dakshinatharindu/Hot-Plate/Enclosure/Hot-Plate-using-PID-main/README.md

# Hot-Plate-using-PID
Hot plate using PID. All circuits tested on Multisim
