dakshinatharindu/Hot-Plate/Report/front.tex

\newcommand{\HRule}{\rule{\linewidth}{0.5mm}} 

\begin{titlepage}
\center
%	HEADING & LOGO
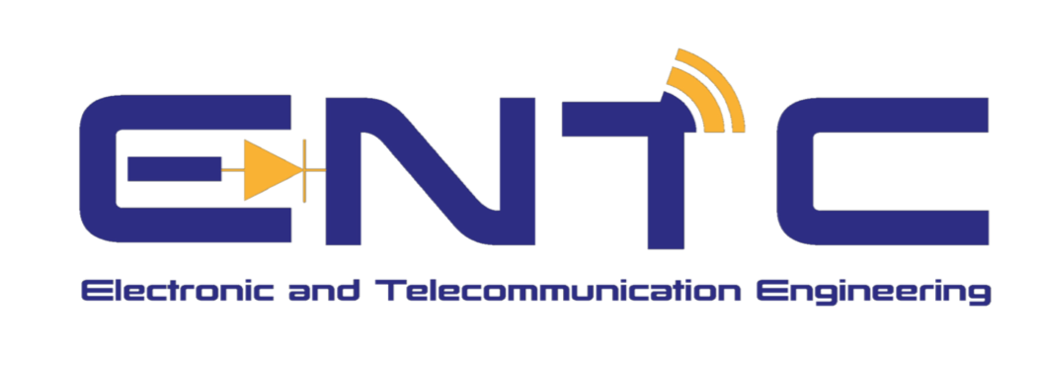
[picture p15: Report/ENTC.png]
\\[1cm]
\textsc{
\Huge \textbf{Department of Electronic \& Telecommunication Engineering}\\[.5cm]
\Large
University of Moratuwa\\[0.5cm] 
Laboratory Practice II - EN2090}\\[0.5cm]

%	TITLE 
\sffamily
\HRule \\[0.4cm]
\textbf{\Huge\textcolor{red}{PID Hotplate Controller}}\\[0.2cm] 
\HRule \\[1cm]
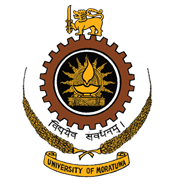
[picture p16: Report/Picture1.png]
\\[1cm]
 \Large
Group 25\\[5mm]
%	AUTHORS & SUPERVISOR
\large
\begin{minipage}[t]{.5\textwidth}
\begin{flushleft}
\emph{ \Large Team Members}

\large 190622R \quad O.K.D. Tharindu\\
\large 190626H \quad P.D. Tharundi \\
\large 190631T \quad T.A. Thenuwara\\
\large 190636M \quad A.G.N. Udara\\
\end{flushleft}

\end{minipage}\hfill\begin{minipage}[t]{.4\textwidth}

\begin{flushright}
\emph{ \Large Course Instructor} 

Mr. Gershorm\\ 

\end{flushright}
\end{minipage}
\end{titlepage}

\begin{abstract}
    This report is a fulfilment for the final evaluation of Laboratory Practice II (EN2090) final group project. We are designing a PID Hotplate controller with analog electronics. As most of Hot plates in the market does not have a temperature controlling mechanism, we are designing a PID feedback controlled temperature managing mechanism. It will help the user to reduce electricity consumption as well as a the life time of the hotplate. We can control the temperature upto $210 ^\circ C$ range. And the controller is designed to work in 2.5KW.
\end{abstract}
