dakshinatharindu/Hot-Plate/Enclosure/Hot-Plate-using-PID-main/Hot Plate/Hot Plate Controller presentation.pptx

## Hot Plate Controller Using PID

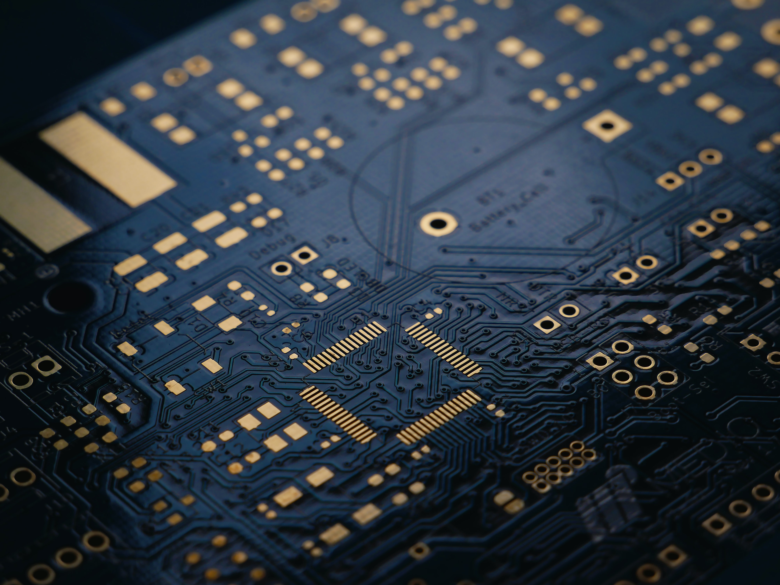
[picture p17: figure]

Group number 19
- 180379R : K.A.G.D. Maheekumara
- 180544U : W.A.V. Ravihansa
- 180604F : P.H.D.S. Silva
- 180715V : U.I.D. Wijethunga

EN2090 – Laboratory Practice II

## Introduction

Power Supply Unit
Sensor interface unit
PID controller Unit
Firing angle controlling system

## Power Supply Unit

## Power supply unit

- This unit is mainly use for give all voltages and current according to the main units.
  - Sensor interfacing unit
  - PID unit
  - Firing angle controller unit
- This unit mainly have 3 parts,
  - Step down part
  - Rectifier part
  - 12V, -12V, 5V output part
- Step down part we mainly use center tapped transformer to convert 230V AC to 12V DC current. Because we cannot use direct house voltage for these circuits.

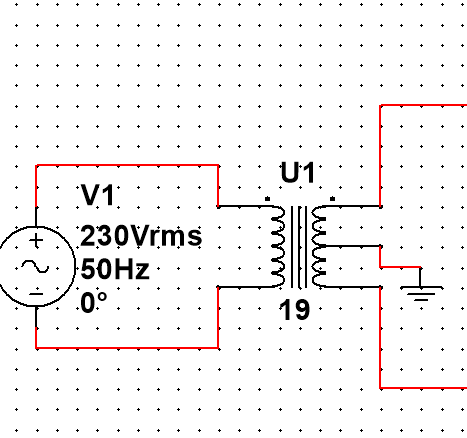
[picture p18: figure]

## Slide 5

- Further we can't use AC current for this circuit so we should convert it to DC current. We can use the second part(Rectifier part) to achieve this purpose. It convert AC voltage to DC voltage.
- Then we can get three output by using,
  - LM7812CT – for 12V DC output
  - LM7912CT – for –12V DC output
  - LM7805CT – for 5V DC output

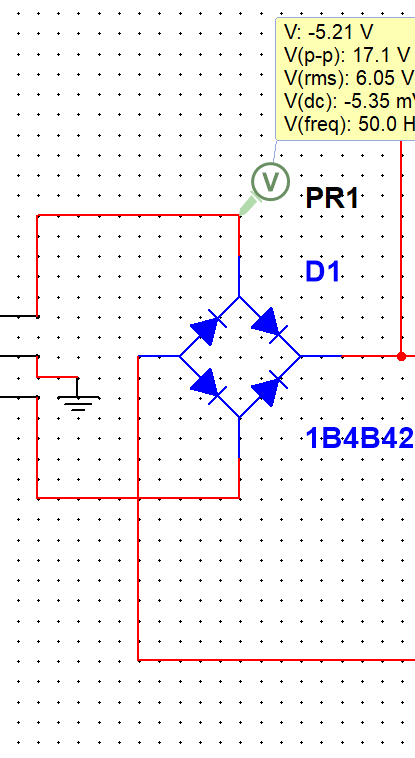
[picture p19: figure]

## Slide 6

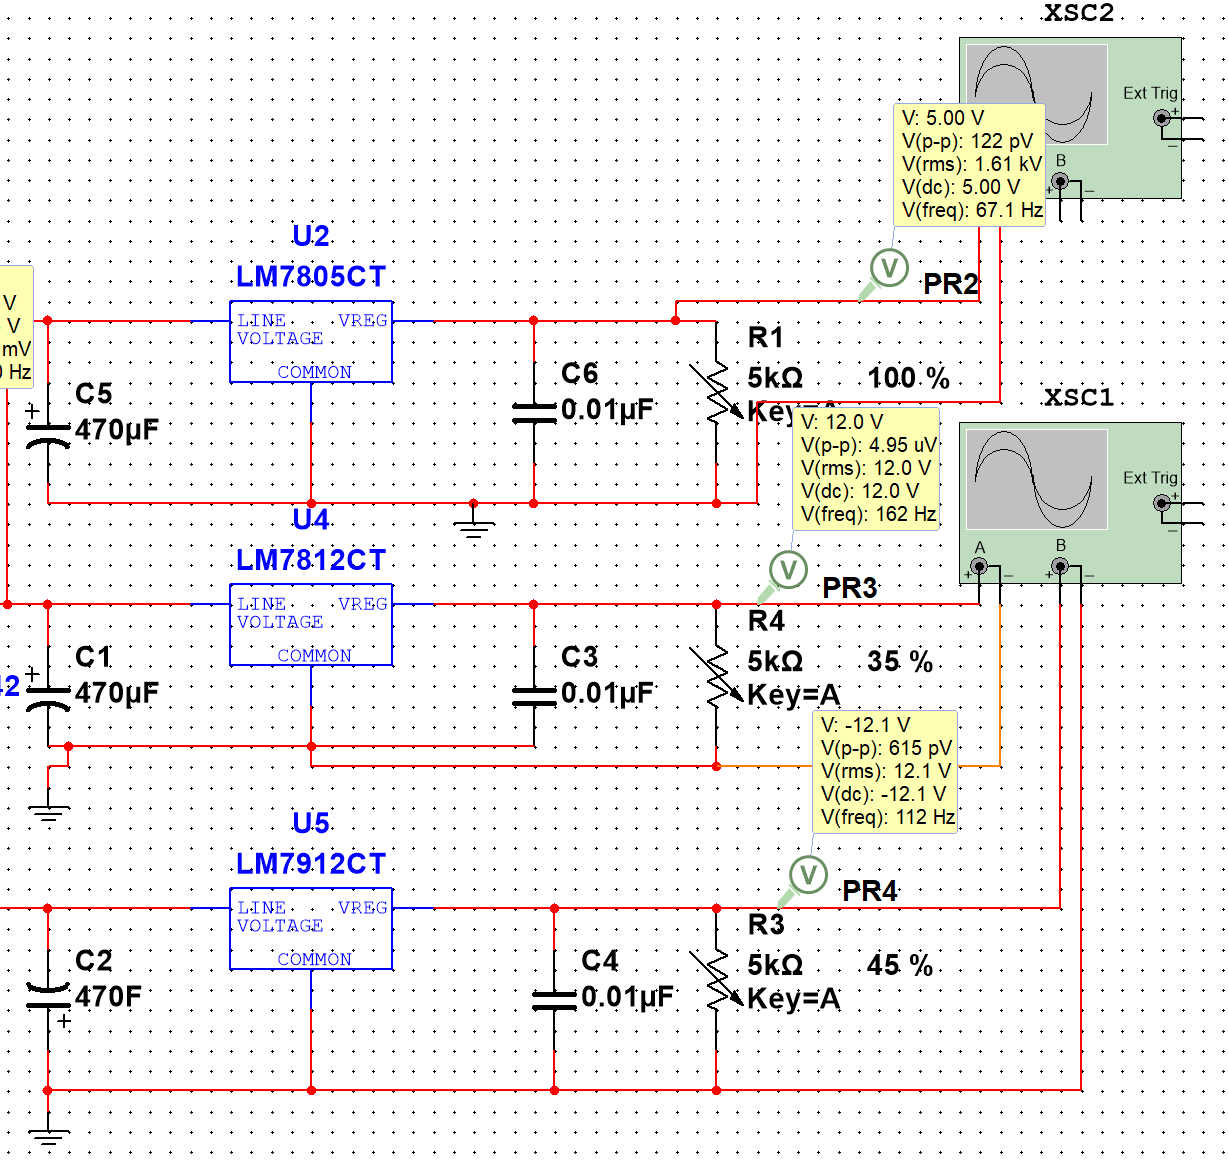
[picture p20: figure]

- Power supply full circuit

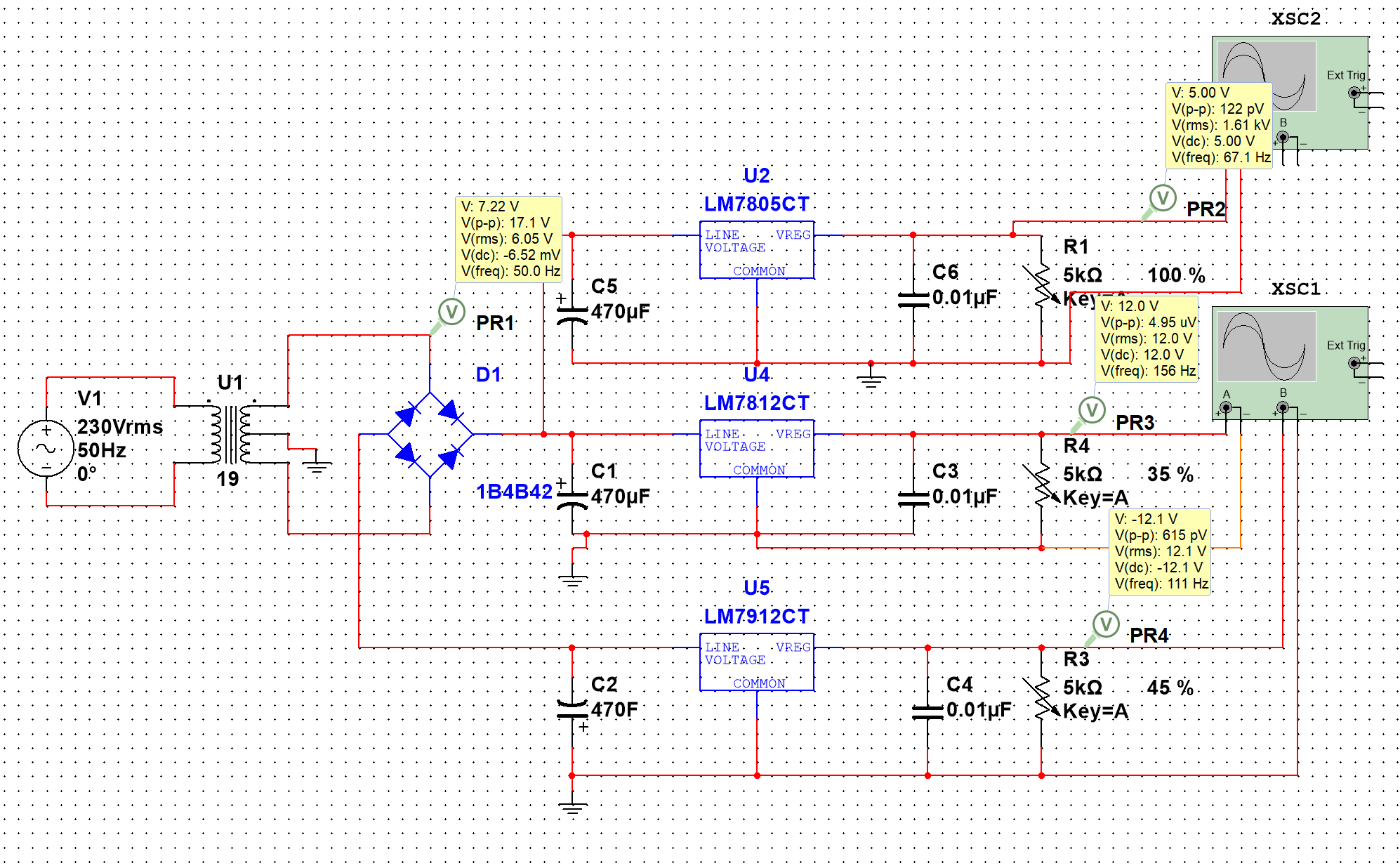
[picture p21: figure]

## Slide 7

Full circuit simulation result
- LM7805CT

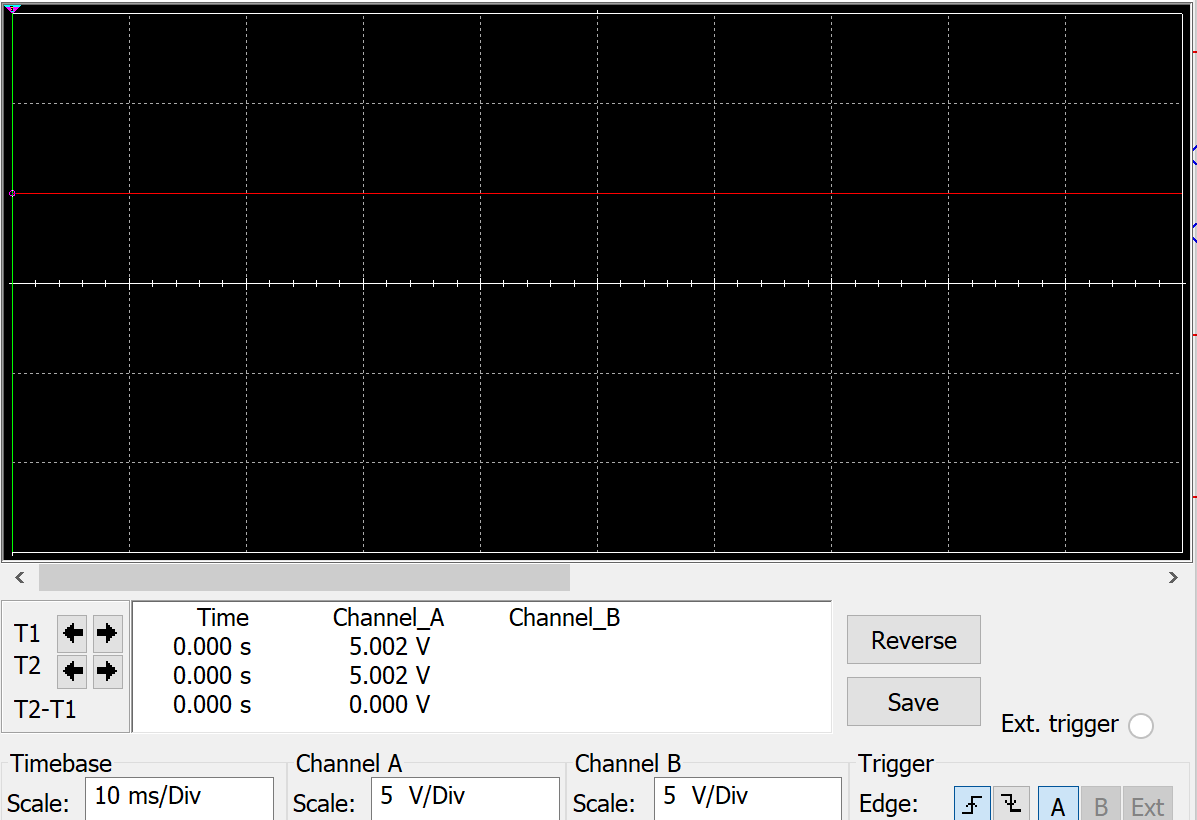
[picture p22: figure]

## Slide 8

LM7812CT and LM7912CT

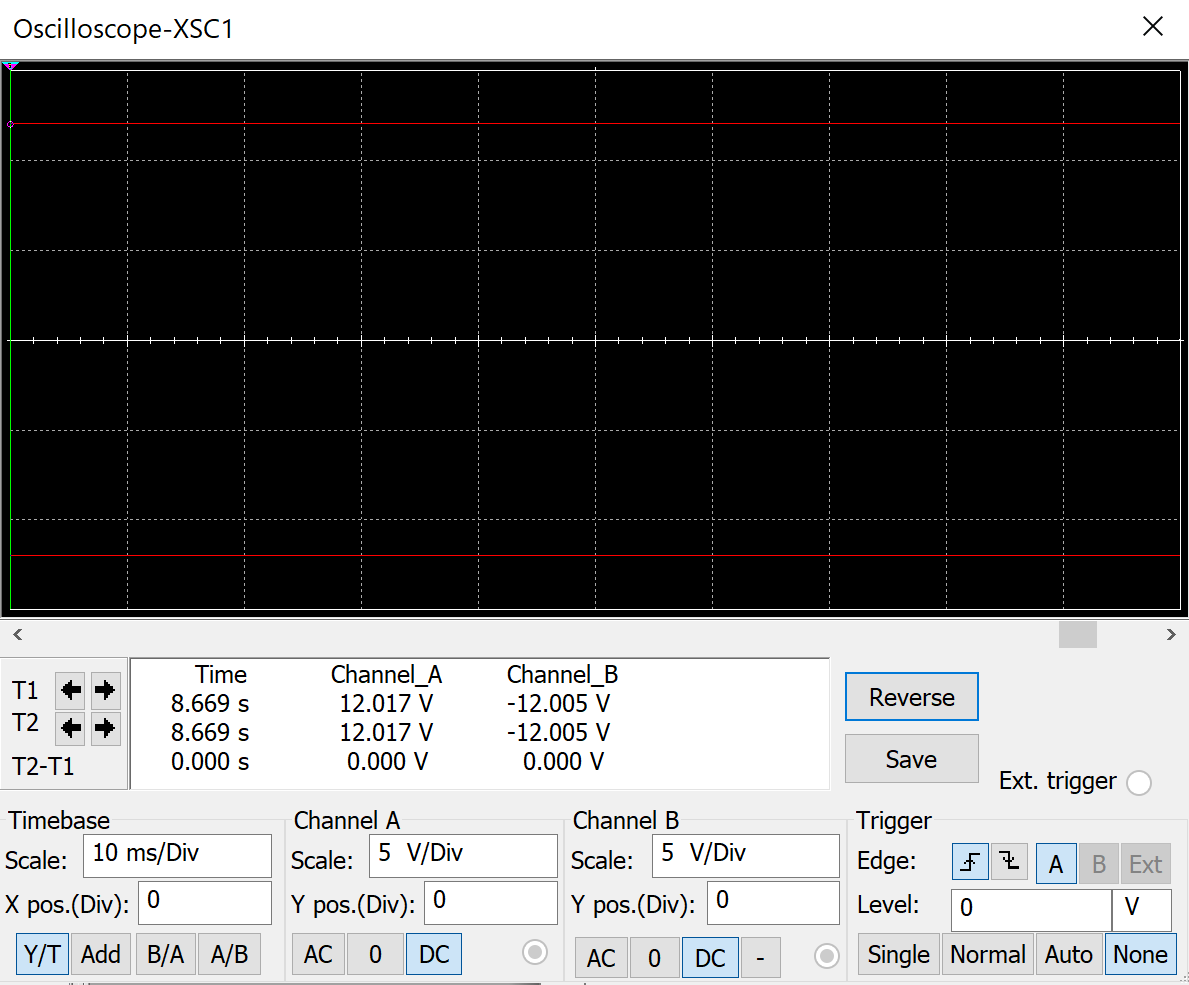
[picture p23: figure]

## Slide 9

- Schematic of Power supply circuit

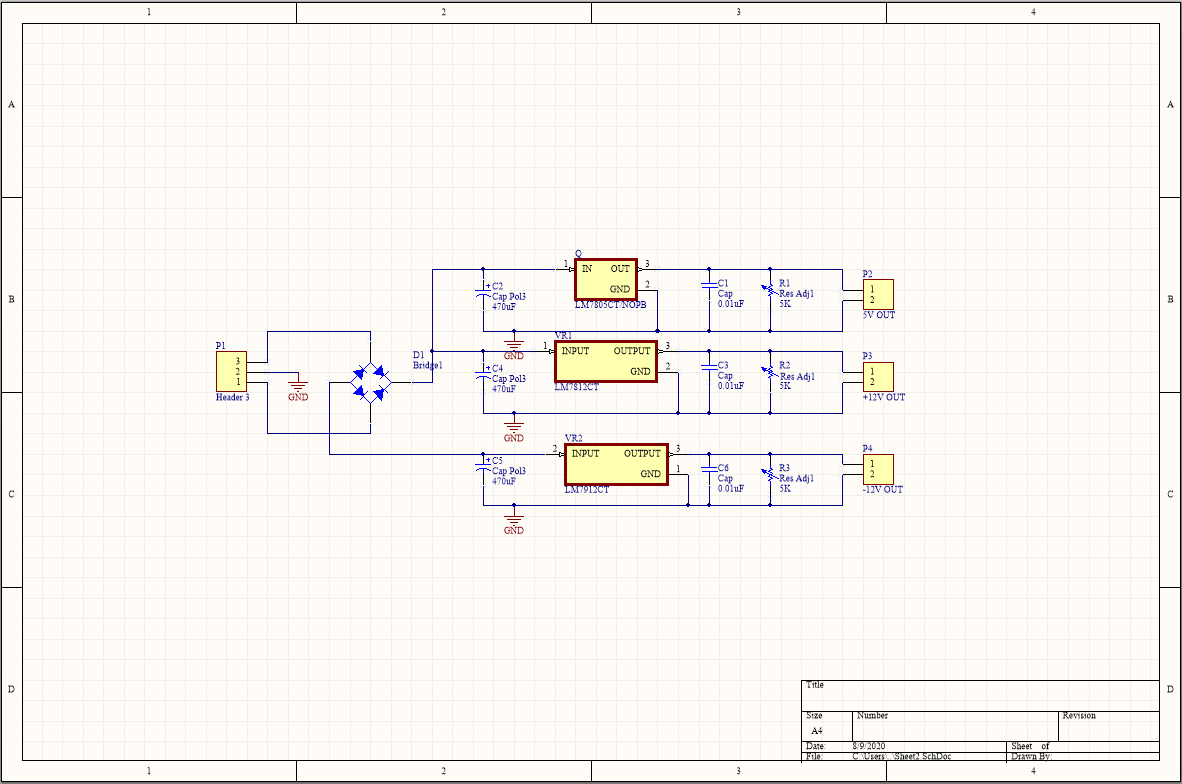
[picture p24: figure]

## Slide 10

- PCB layout of the power supply circuit

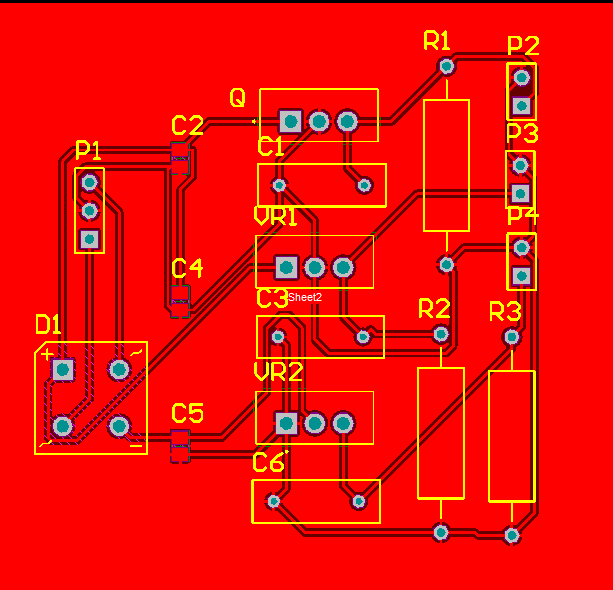
[picture p25: figure]

## SENSOR INTERFACE UNIT

## The resistance variation of the selected sensor RTD Pt100 with temperature is approximately linear,

RTD (T ) ≈ RTD0 ( 1 + T × α )
Where:
RTD(T) = the RTD element’s resistance at T (Ω)
RTD0 = the RTD element’s resistance at 0°C (Ω) (100 Ω for Pt100)
T = the RTD element’s temperature (°C)
α = 0.00385 Ω/Ω/°C (Temperature coefficient of RTD element)
As per actual readings obtained for temperature range 0-200°C the resistance varies in the range 100 –175.86 Ω.
(https://www.tnpinstruments.com/sitebuildercontent/sitebuilderfiles/pt100_385c_table.pdf)

## Slide 13

Analog circuit to take the required temperature, read the sensor reading and to output the difference in temperature as a voltage level.

Comprises with,
- 1mA constant current source.
The RTD requires a 1mA or less constant current for proper operation.
- Error generation and amplification unit.
Generation of error (difference between sensor reading and desired temperature as a voltage - input for PID unit).

## Constant current source

- U3B and R3, R4, R7, R8 resistors serve as a differential amplifier with gain=1,
- VOUT_U3B= 1*( VJ2 – (- VOUT_U3C ))
- VJ2 = VCC/2 =6V
- Since U3C is a unity gain amplifier VOUT_U3C = VJ1 .
- VR2 = VOUT_U3B - VJ1
- = VOUT_U3B - VOUT_U3C
- = VJ2 = 6V
- Therefore current supplied to the sensor= VR2 / R2
- = 1mA.
- ( No backflow at J1 since op amp input resistance is high)

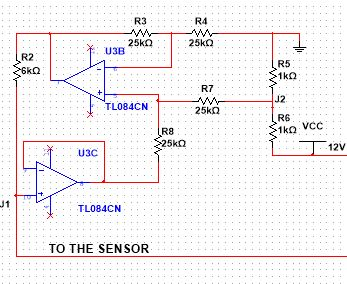
[picture p26: figure]

## Error Generation

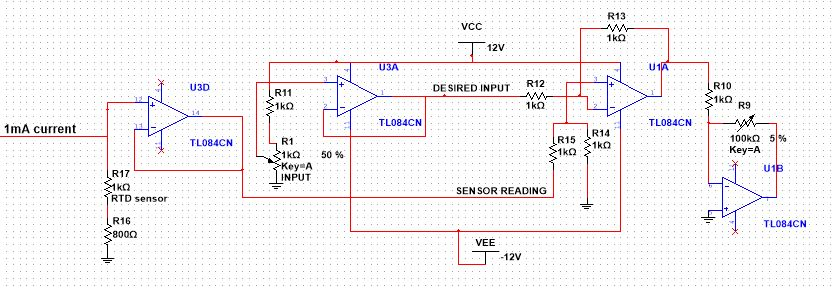
[picture p27: figure]

- U3D is a unity gain op amp ( to isolate circuit currents),
- VOUT_U3D = sensor reading = (RTD resistance + R16) * 1mA
- For simulation purposes a potentiometer is used to input the desired input. U3A is a unity gain op amp ,
- VOUT_U3A = desired input
- U1A is a differential amplifier with gain=1 since all resistance values from R12 to R15 are equal.
- VOUT_U1A = 1 x (sensor reading - desired input)
- = Error input for PID unit
- U1B is an inverting amplifier with variable gain( set by R9 potentiometer and R10 ),
- variable gain = R9/R10

## Slide 16

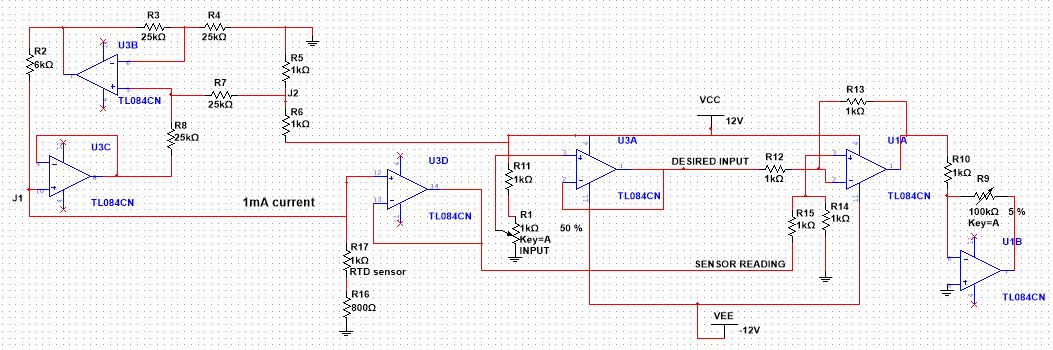
[picture p28: figure]

## ERROR and VOLTAGE ACROSS RTD VS. RTD RESISTANCE (AT 0.9V DESIRED INPUT)

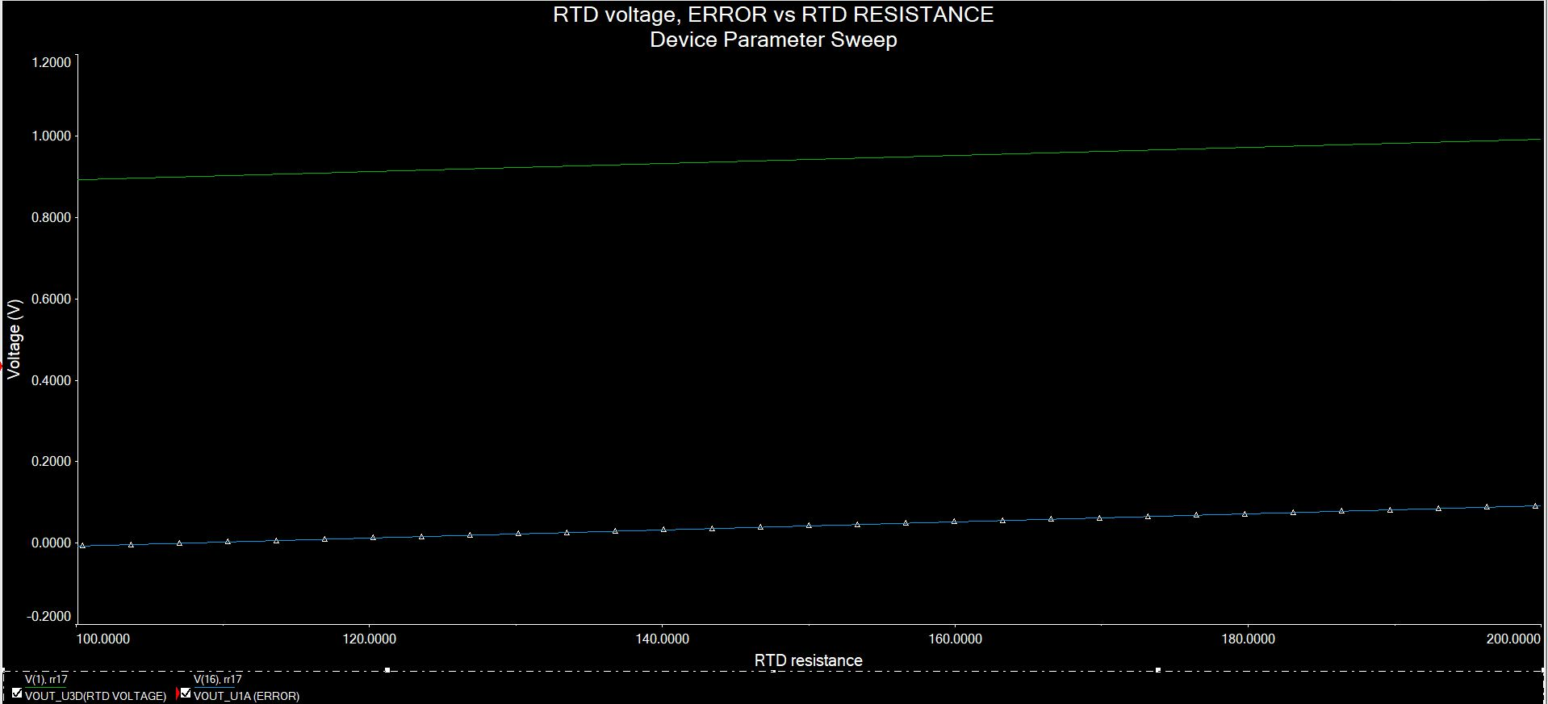
[picture p29: figure]

## CONSTANT CURRENT SUPPLY vs RTD RESISTANCE

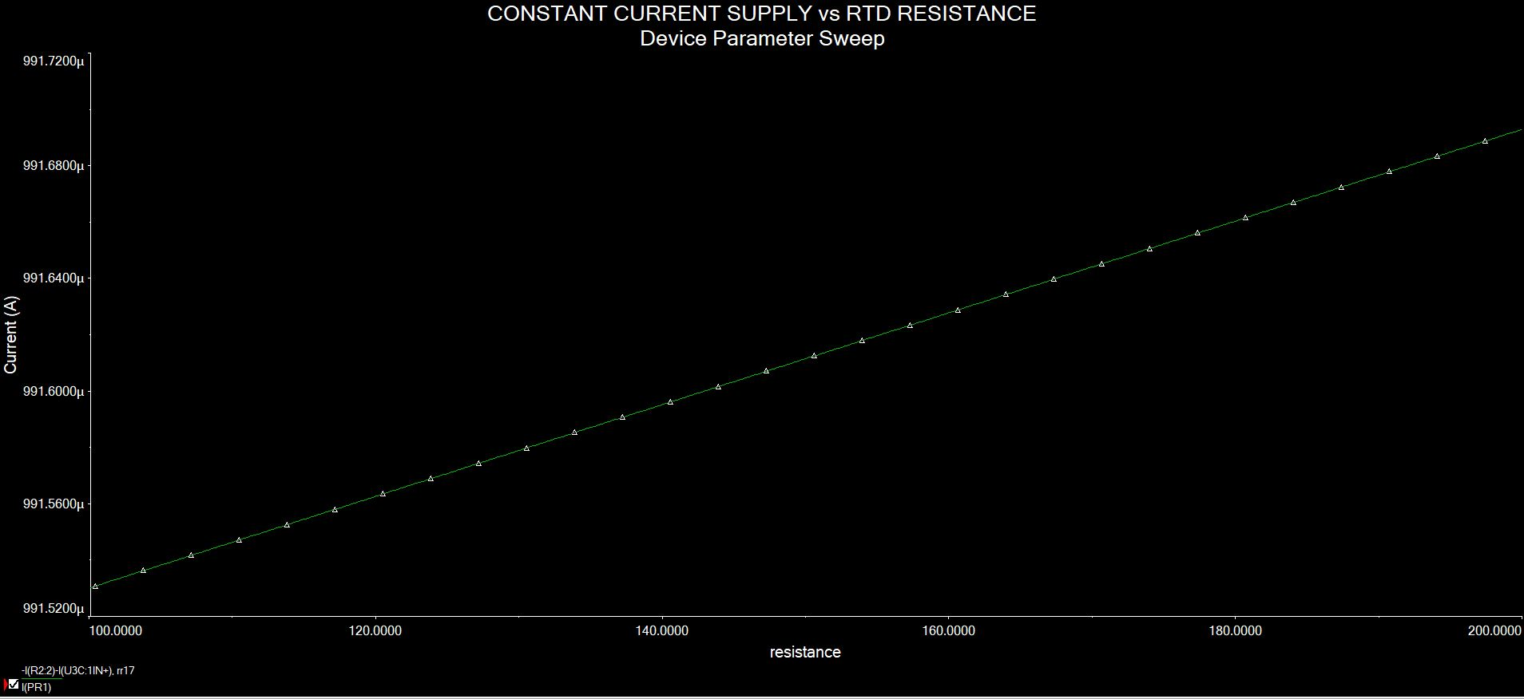
[picture p30: figure]

## PCB Layout

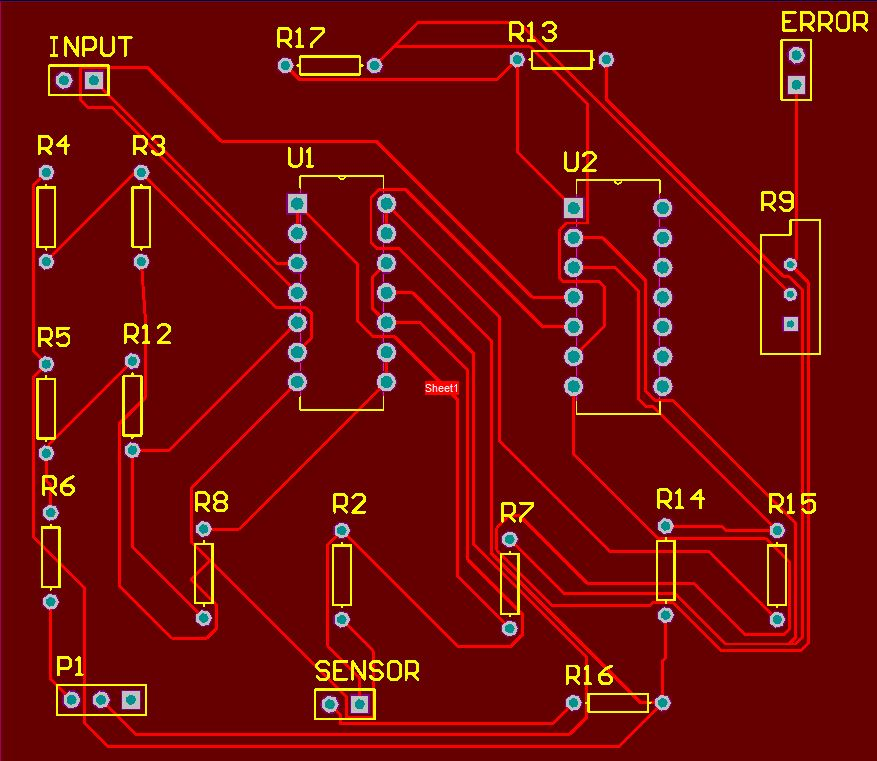
[picture p31: figure]

## PID Controller Unit

## PID CONTROLLER UNIT

The purpose of this unit is take the error between desire value and sensor output value which is generated by the sensor unit. Then this error signal goes through the PID control unit and generate the output controlling signal which is input to the PWM unit.
This unit has three main parts.
- Proportional
- Integral
- Derivative
Block diagram
output(t)=K_p V_(error) + K_i ∫ V_(error) + K_d (d(V_(error) ))/(dt)

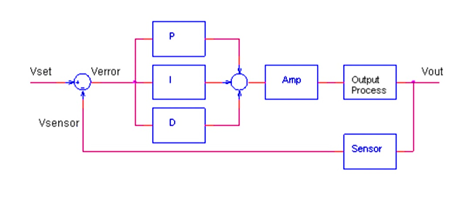
[picture p32: figure]

## Proportional circuit

We use proportional circuit to produce a one control signal which is proportional to the input error signal. This reduce large part of overall error.
Circuit and simulation result
Pout= K_p ∗V_(error)
K_p = R_(P2) /R_(P1) (proportional gain constant)
- We have to change the Kp value to control the gain of the output.

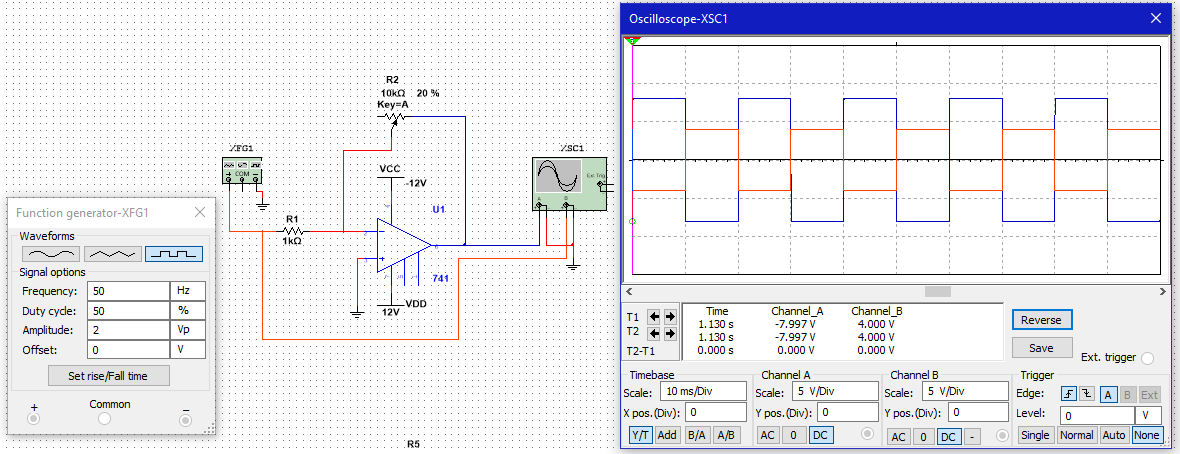
[picture p33: figure]

## Integral circuit

We use integral circuit to produce sum of the instantaneous error over time.
Circuit and simulation result
Iout= K_I ∗ ∫ V_(error) dt
K_I =1/(R_I C_I ) (integral coefficient)
- In the figure we use resistor parallel to the feedback capacitor. The purpose of that resistor is reduce the gain in output.

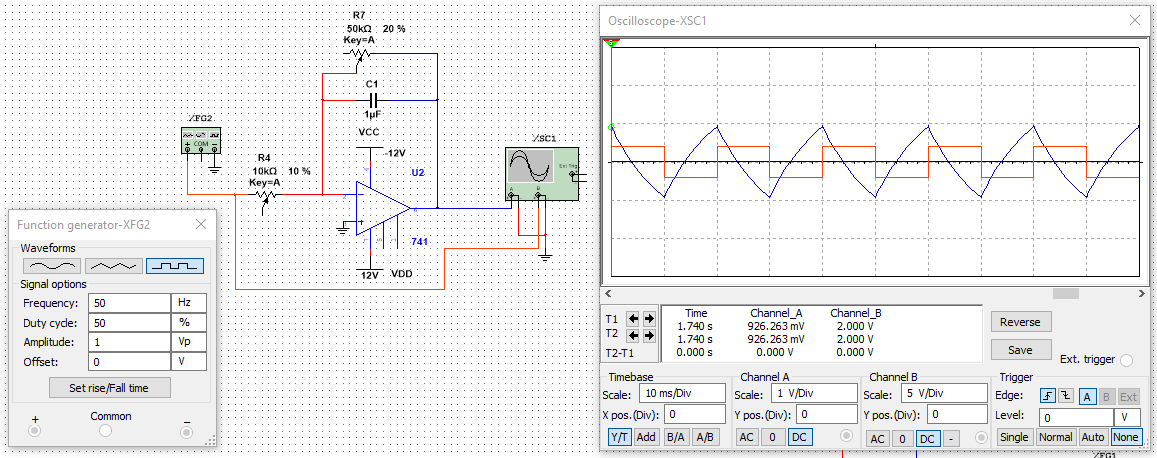
[picture p34: figure]

## Derivative circuit

This circuit counteracts the proportional gain and the integral gain when the output changes quickly.
Circuit and simulation result
D_(out) = K_d ∗ (dV_(error))/(dt)
K_d = R_d ∗C_d (derivative coefficient)
- In the above figure we used resistor series with input capacitor. The reason is circuit may amplify unwanted noises. We can reduce the output gain by using capacitor parallel to the feedback resistor.

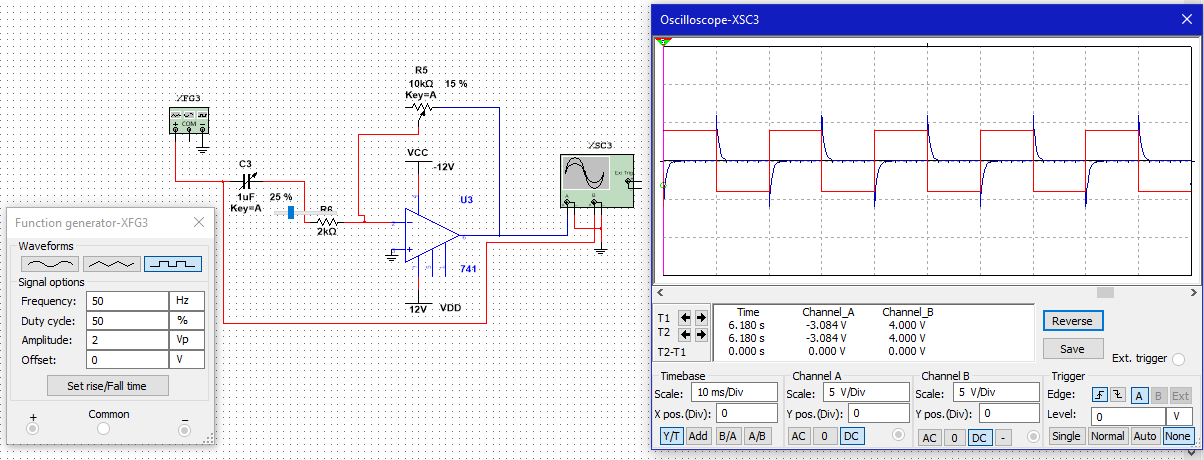
[picture p35: figure]

## Slide 25

- Derivative circuit also helps to reduce the overshoot.

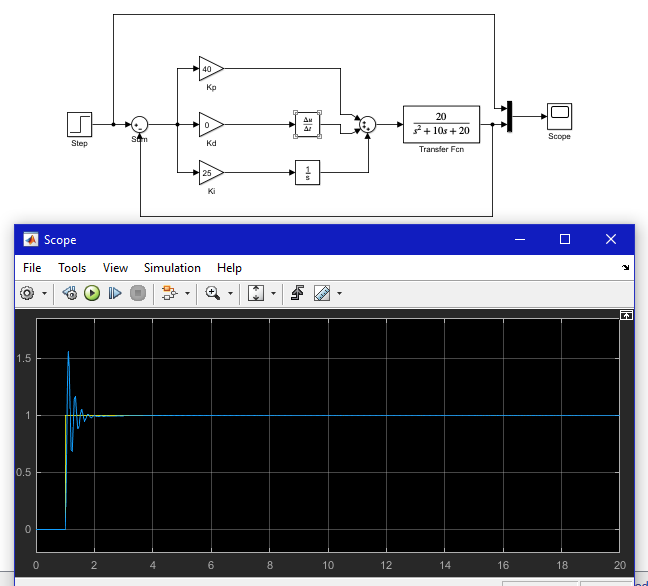
[picture p36: figure]

With out Kd

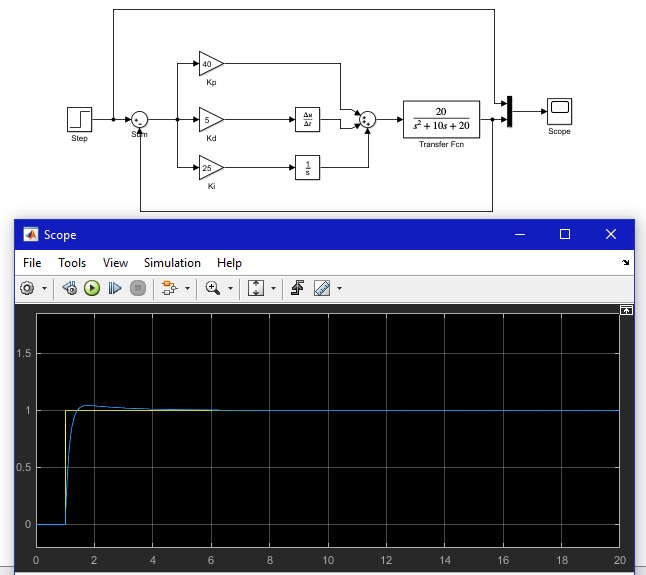
[picture p37: figure]

With Kd

## FINAL CIRCUIT SIMULATION RESULT

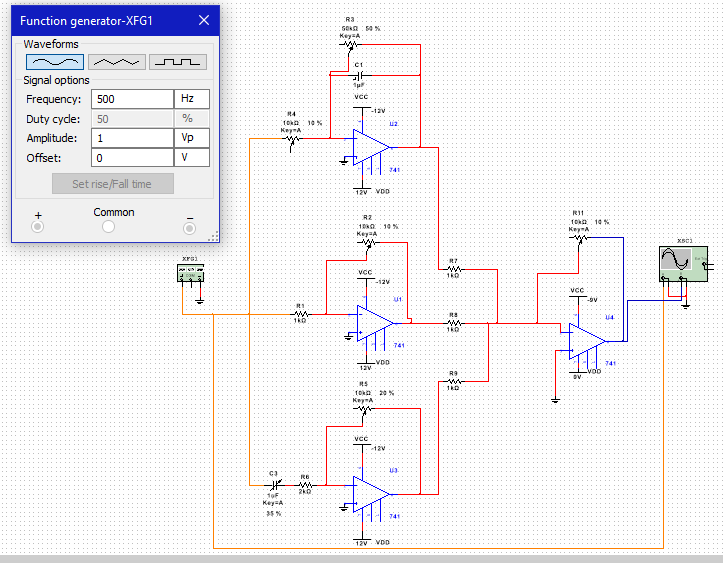
[picture p38: figure]
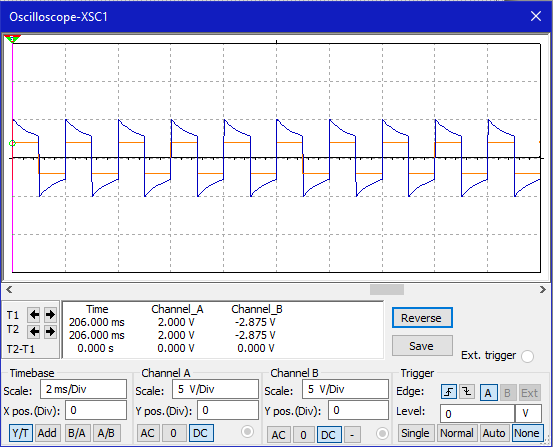
[picture p39: figure]

## PID TUNING

Tuning means adjusting three multipliers Kp, Ki, Kd. We have to adjust these values until we get the desire output from the system.
Tuning method
- Set Kp. Starting with Kp = 0, Ki = 0 and Kd = 0, increase Kp until the output starts overshooting and ringing significantly.
- Set Kd. Increase Kd until the overshoot is reduced to an acceptable level.
- Set Ki. Increase Ki until the final error is equal to zero.

## Slide 28

Schematic and PCB layout

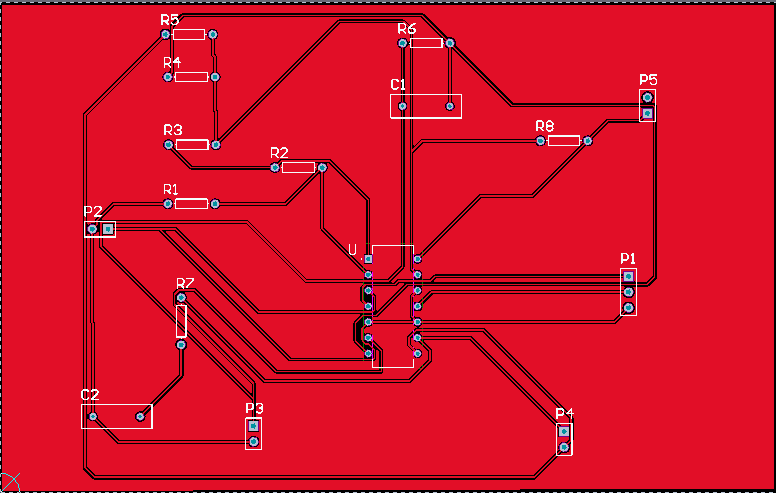
[picture p40: figure]
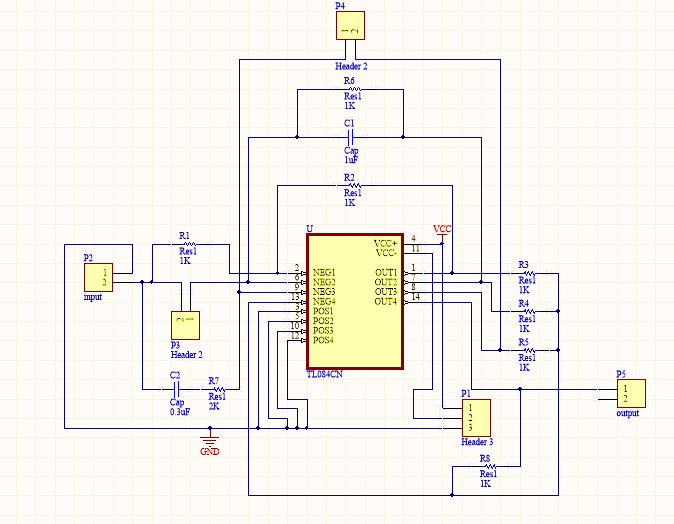
[picture p41: figure]

## Firing Angle Controlling System

## Firing Angle Controlling System

- Controls the transferring power to hotplate according to the PID output.
- Four main parts.
  1. Zero crossing detection
  2. Ramp generation
  3. PWM signal generation
  4. Triggering circuit

## Zero crossing detection

- Provides a pulse train in a frequency that is twice as the 230V AC supply.

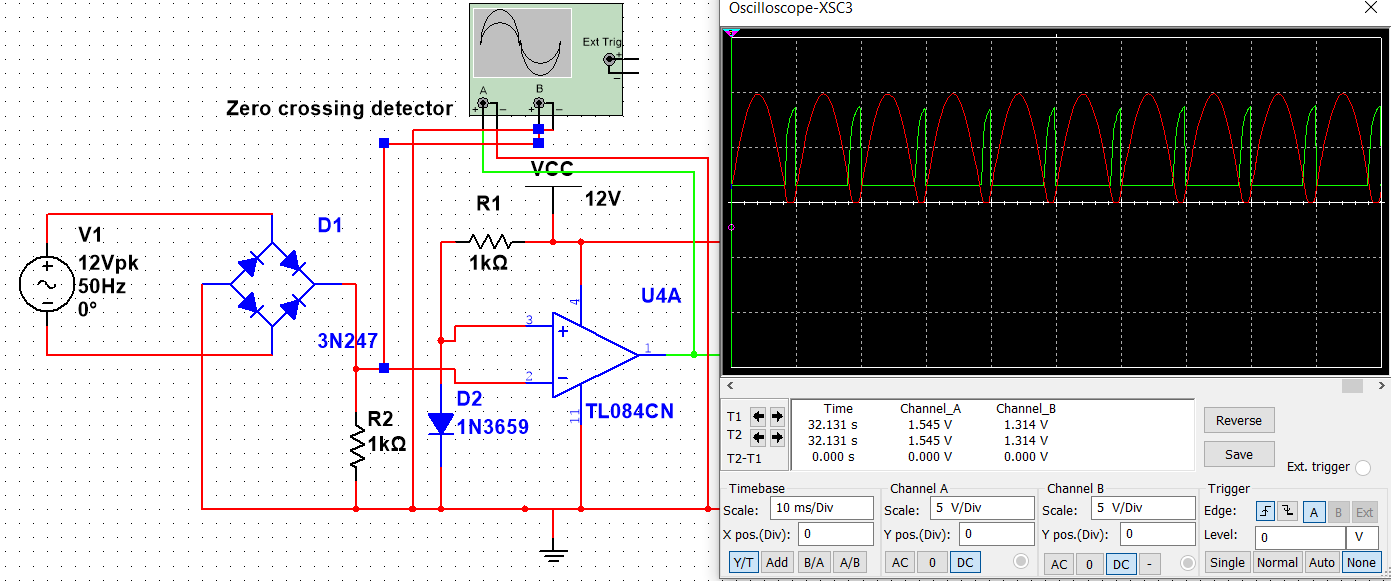
[picture p42: figure]

V_(+) =V_b (Barrier voltage of the D2)
V_(−) = rectifier output voltage
Op amp act as a comparator,
Therefore ,
If V_(+) > V_(−) ,
V_o =+V_s
If V_(+) < V_(−) ,
V_o =−V_s
Maximum current through the diode(In datasheet) = 30A
R1=1kΩ
Current through the diode in this circuit ≈ 11.4mA

## Ramp generation

- Creates a ramp using each pulse.

- The pulse train is given to the base of the transistor.
- When base voltage is low, the transistor act as a open switch.
V_C =V_(CC)
Capacitor is charge up to the collector voltage.
- When base voltage is high, the transistor is act as a closed switch. Collector-Emitter voltage will be nearly zero. Capacitor will discharge through the transistor.

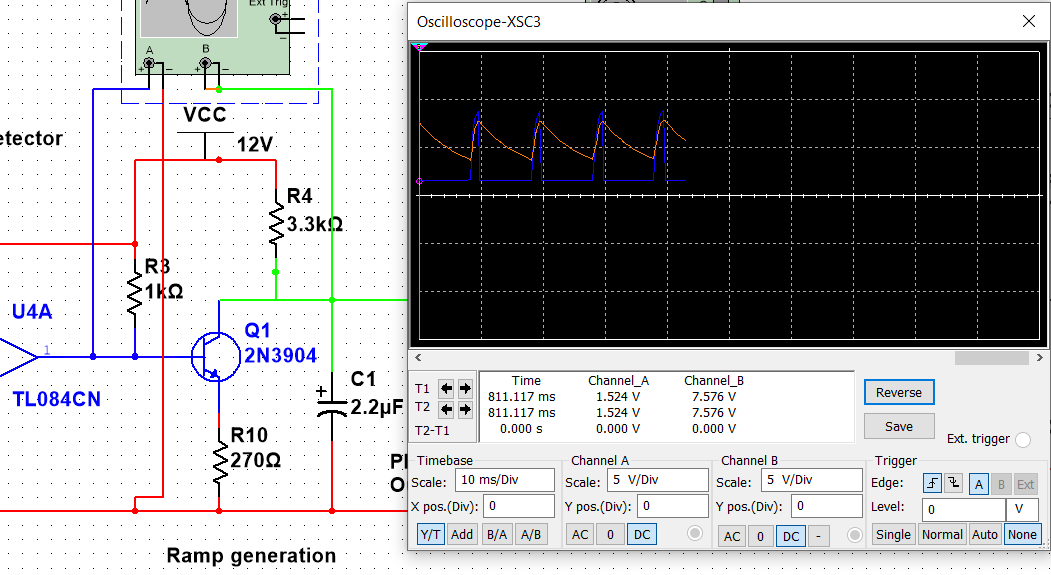
[picture p43: figure]

## PWM signal generation

- Provides a PWM signal which changes its pulse width according to the PID output signal.

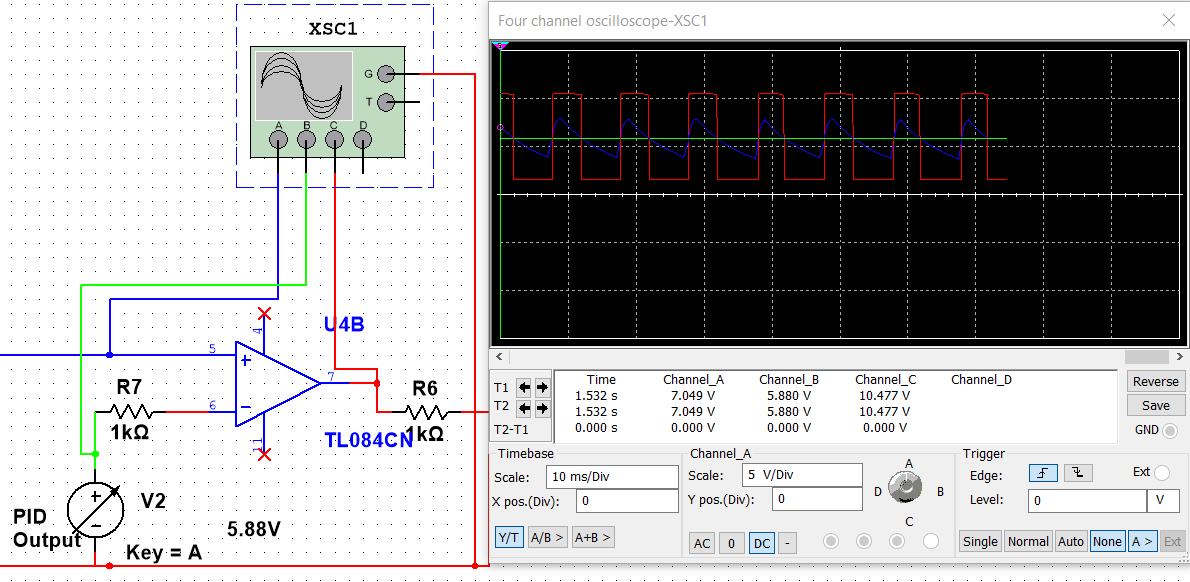
[picture p44: figure]

Op amp act as a comparator,
V_(+) =generated ramp wave
V_(−) =PID output signal
If V_(+) >V_(−) ,
V_o =+ V_s (12V)
If V_(+) <V_(−) ,
V_o =− V_s (0V)

## Triggering Circuit

- This circuit is isolated using an opto-transistor to protect the low power, control circuit from the 230V circuit.
- Once the triac is triggered using a high voltage it allows to flow current trough out the circuit until current becomes zero.

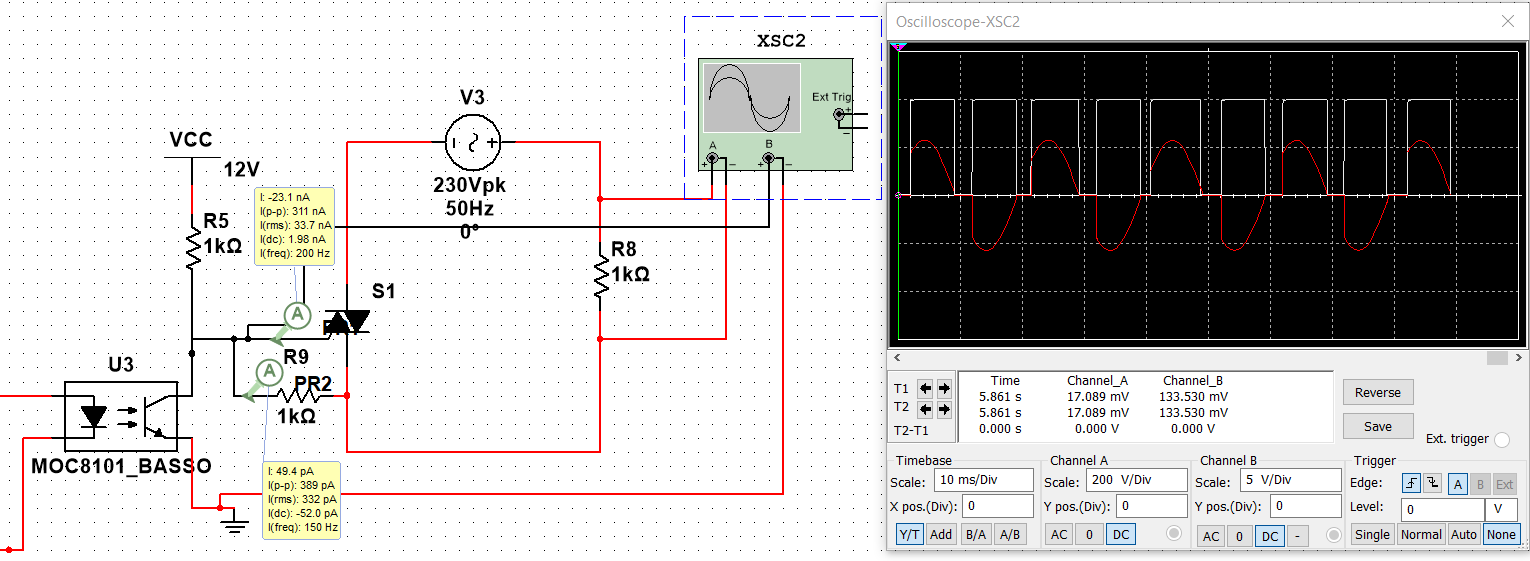
[picture p45: figure]

## Simulation

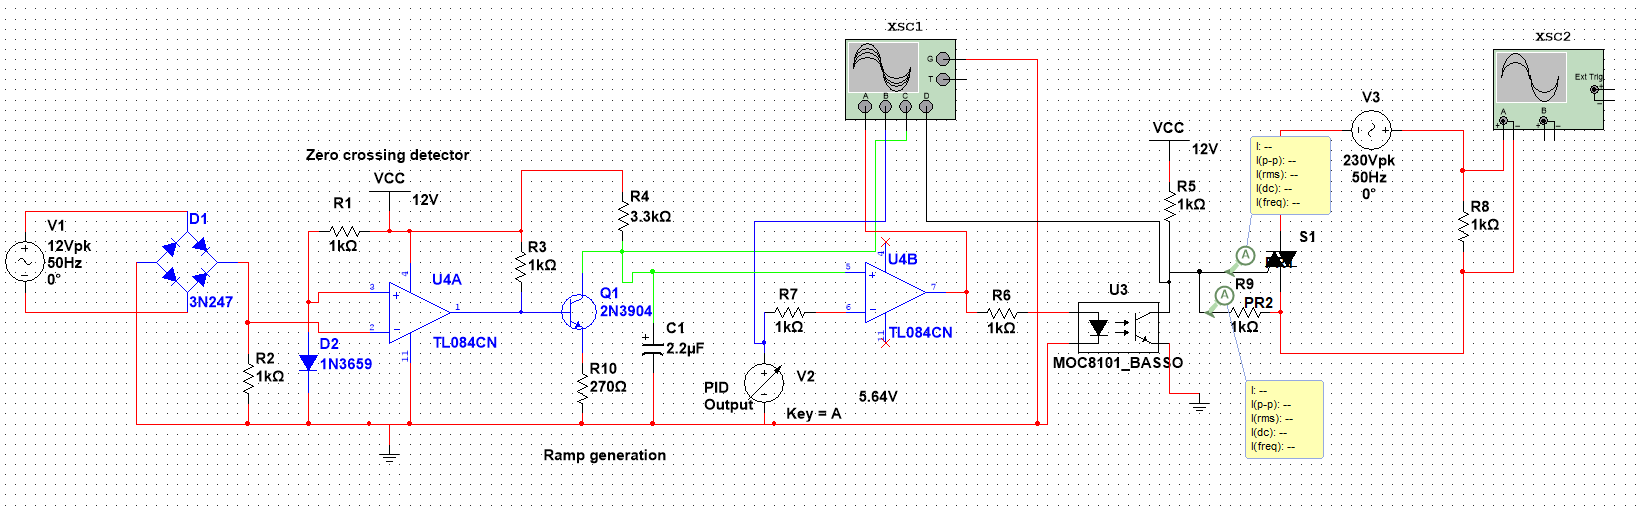
[picture p46: figure]

## Slide 36

- Schematic of Firing angle control circuit

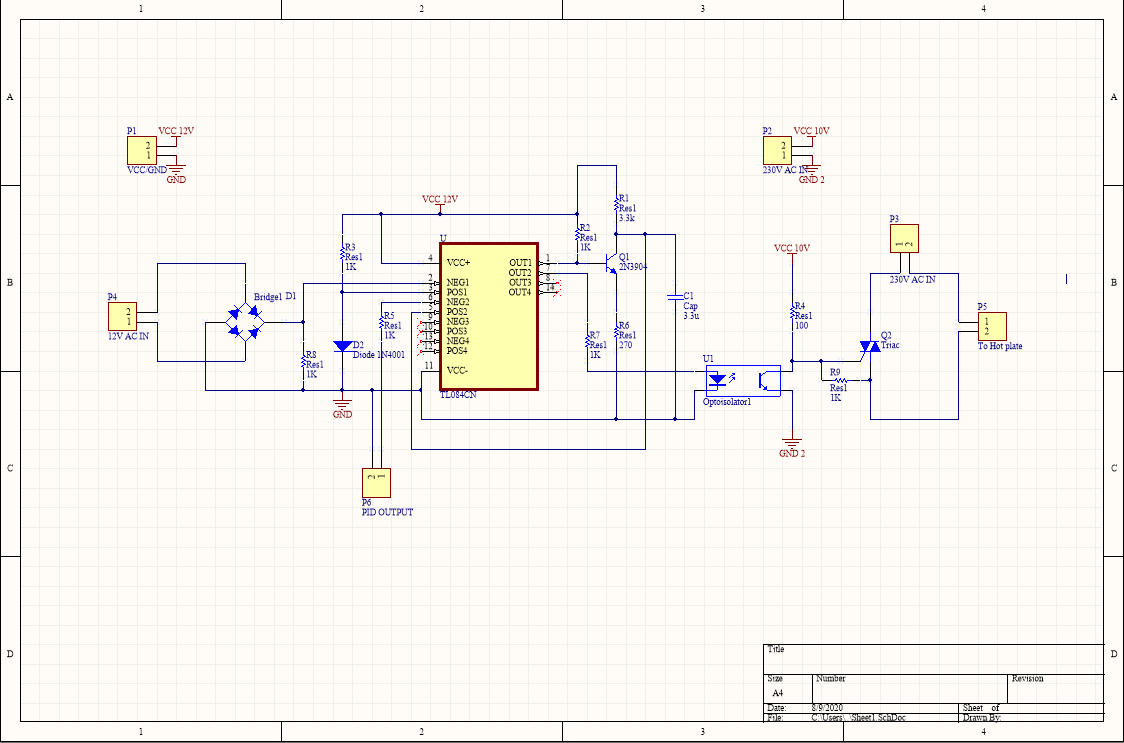
[picture p47: figure]

## Slide 37

- PCB layout of the firing angle control system

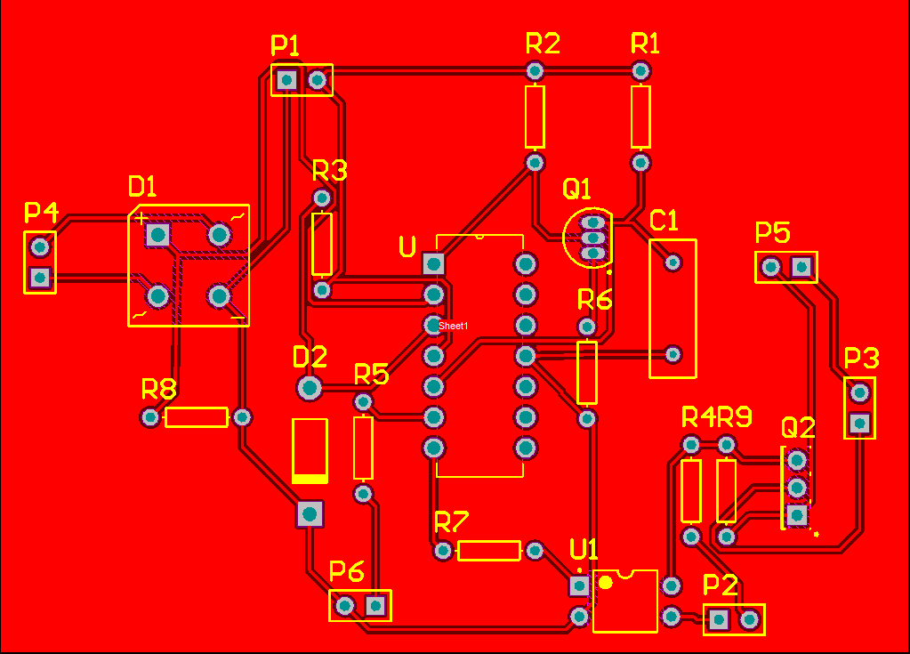
[picture p48: figure]

## Task Delegation

Index | Name | Task
180379R | K.A.G.D. Maheekumara | Power supply unit
180544U | W.A.V. Ravihansa | PID controller unit
180604F | P.H.D.S. Silva | Sensor interface
180715V | U.I.D. Wijethunga | Firing angle control system

## Thank you
