dakshinatharindu/Hot-Plate/Report/Method/LM339.pdf

2 | 3

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
Output 2

- Input 1

Output 1

Output 3

Output 4

+ Input 1

- Input 2

+ Input 2

+ Input 4

- Input 4

+ Input 3

- Input 3
VCC | GND

4
