dakshinatharindu/Hot-Plate/Report/Method/PWM width controller circuit.pdf

24K

Sensor
Out

12V

Ramp
wave

12V

GND

PID
