dakshinatharindu/Hot-Plate/Report/Method/Ramp gen cropped.pdf

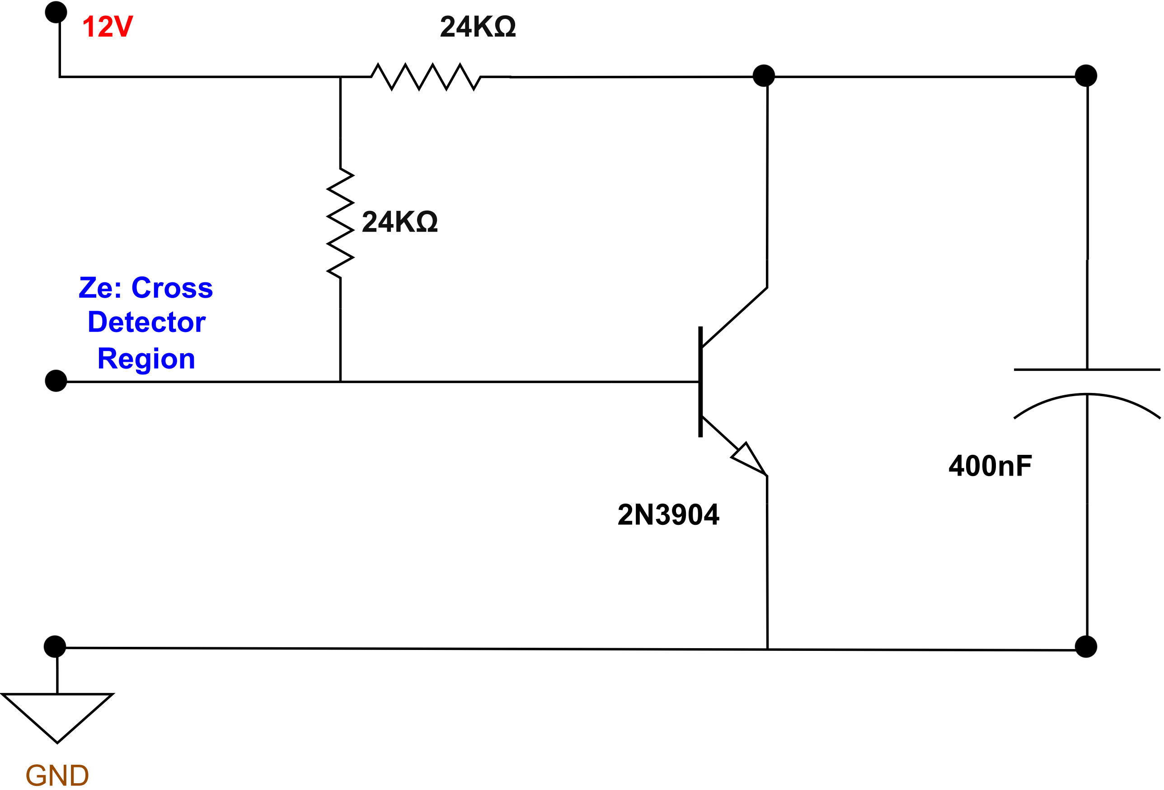
[picture p49: figure]
Ze: Cross Detector Region; GND
