dakshinatharindu/Hot-Plate/Report/Method/Scalers.pdf

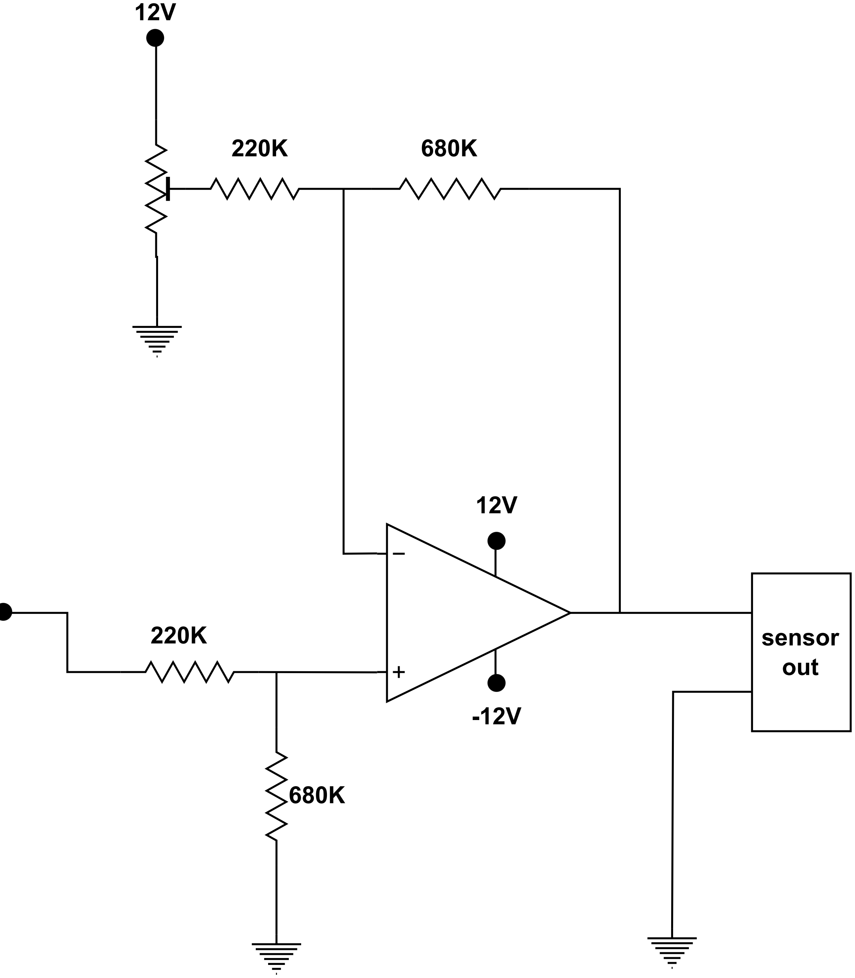
[picture p50: figure]
sensor out
