dakshinatharindu/Hot-Plate/Report/Method/Constant current.pdf

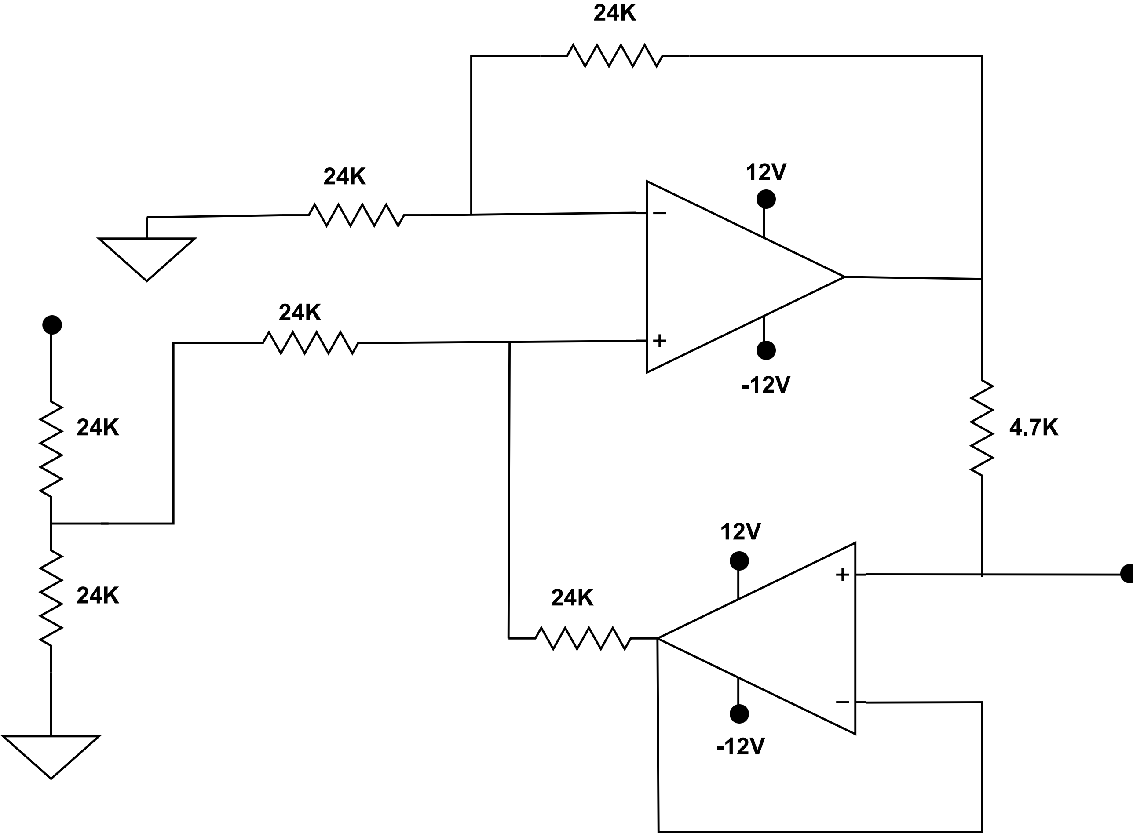
[picture p67: figure]
