dakshinatharindu/Hot-Plate/Report/Method/contant2.pdf

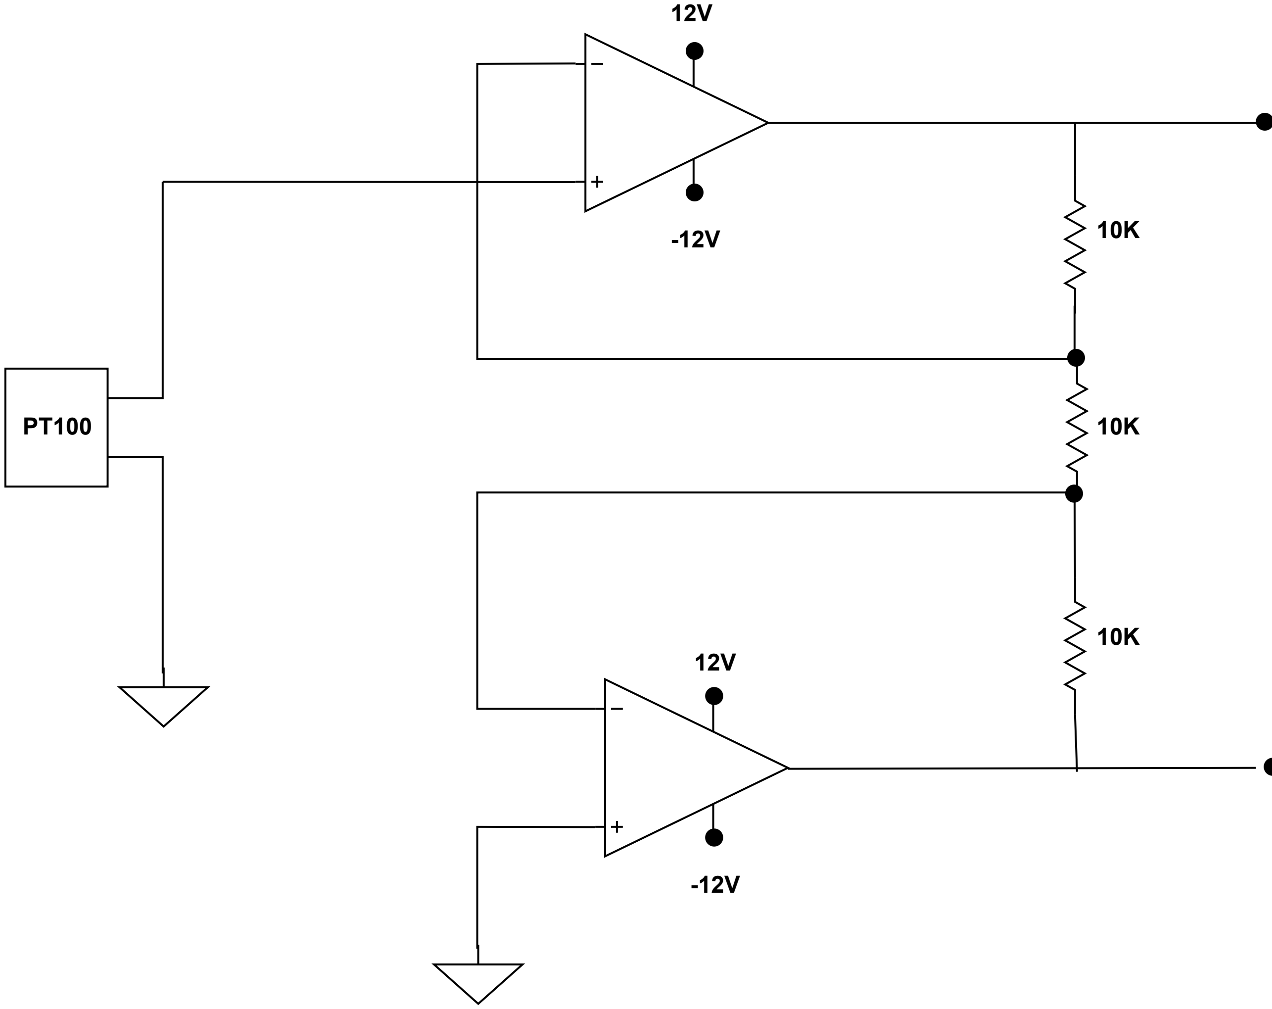
[picture p68: figure]
