dakshinatharindu/Hot-Plate/Report/Method/ins.pdf

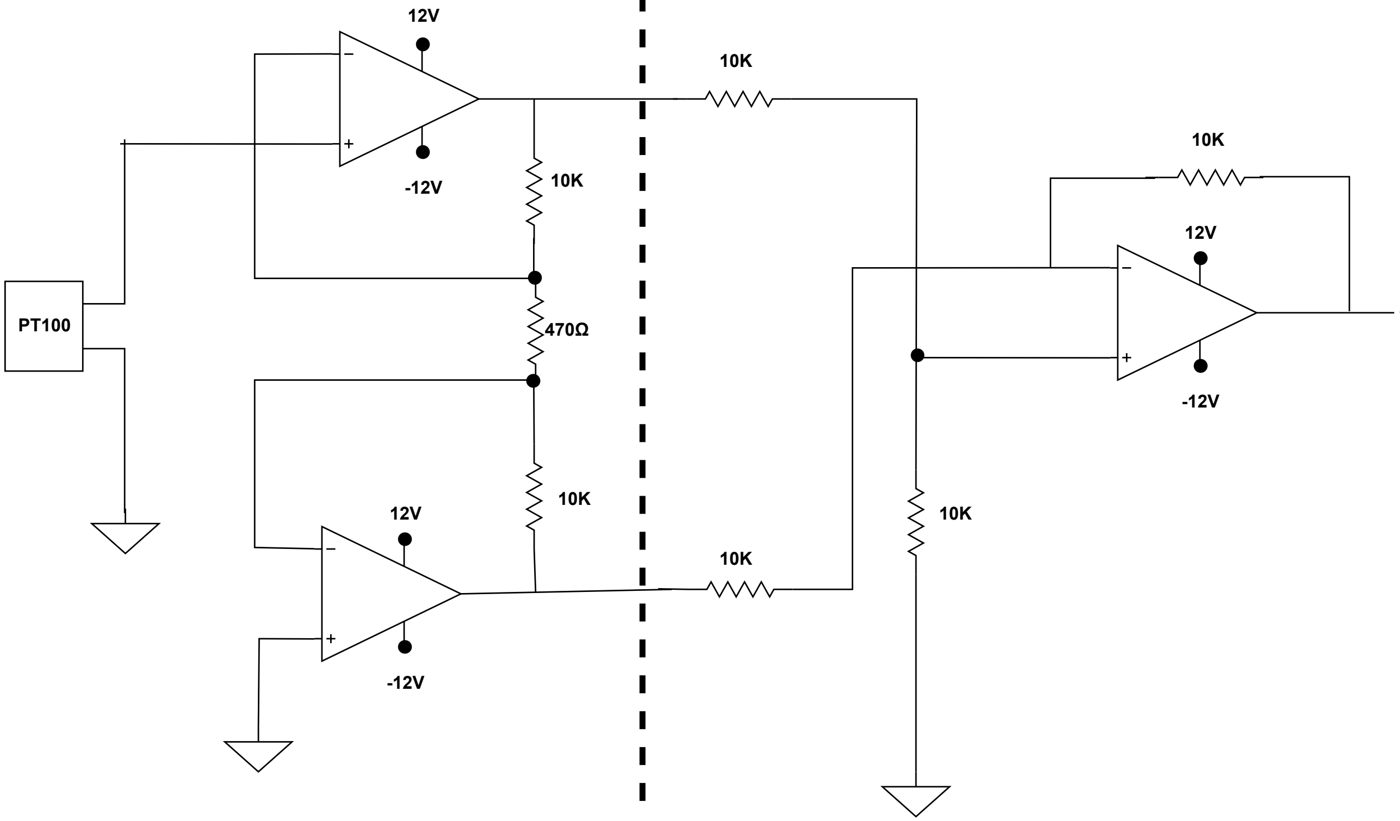
[picture p69: figure]
