dakshinatharindu/Hot-Plate/Report/PID/D.pdf

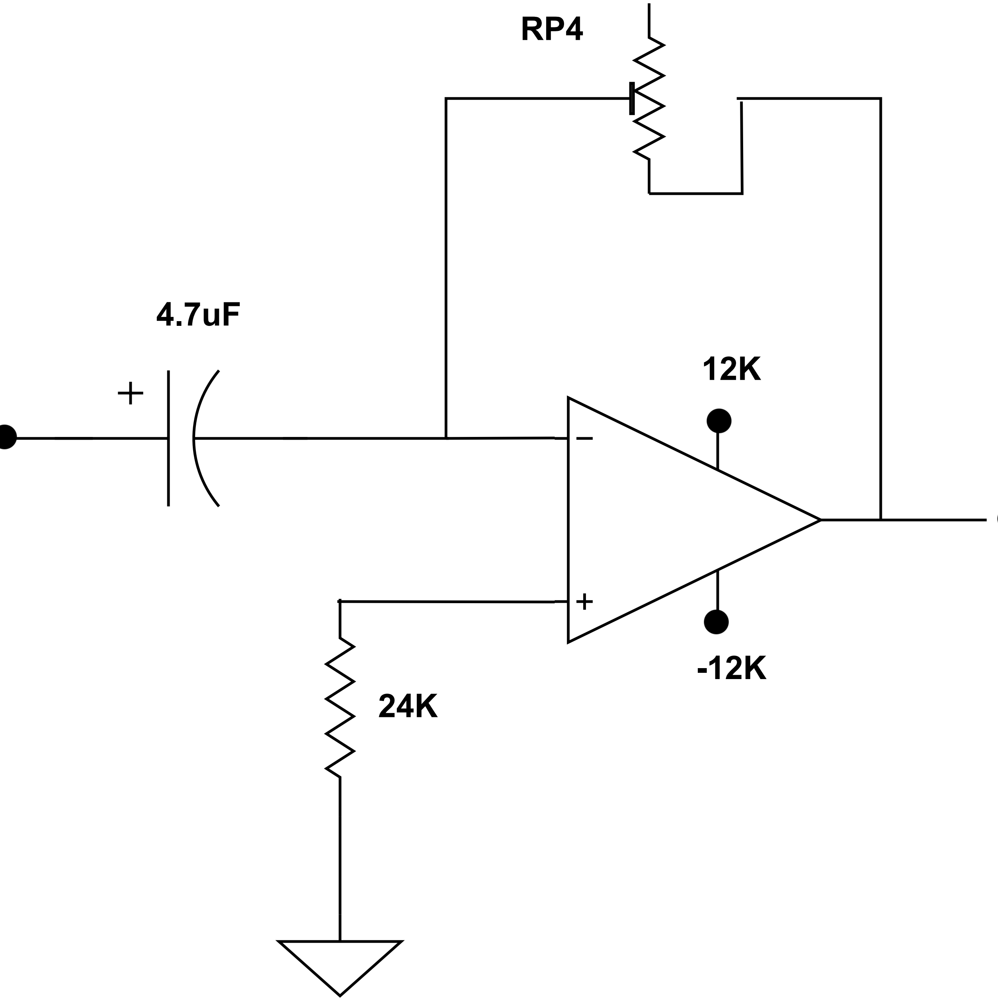
[picture p70: figure]
