dakshinatharindu/Hot-Plate/Report/PID/I.pdf

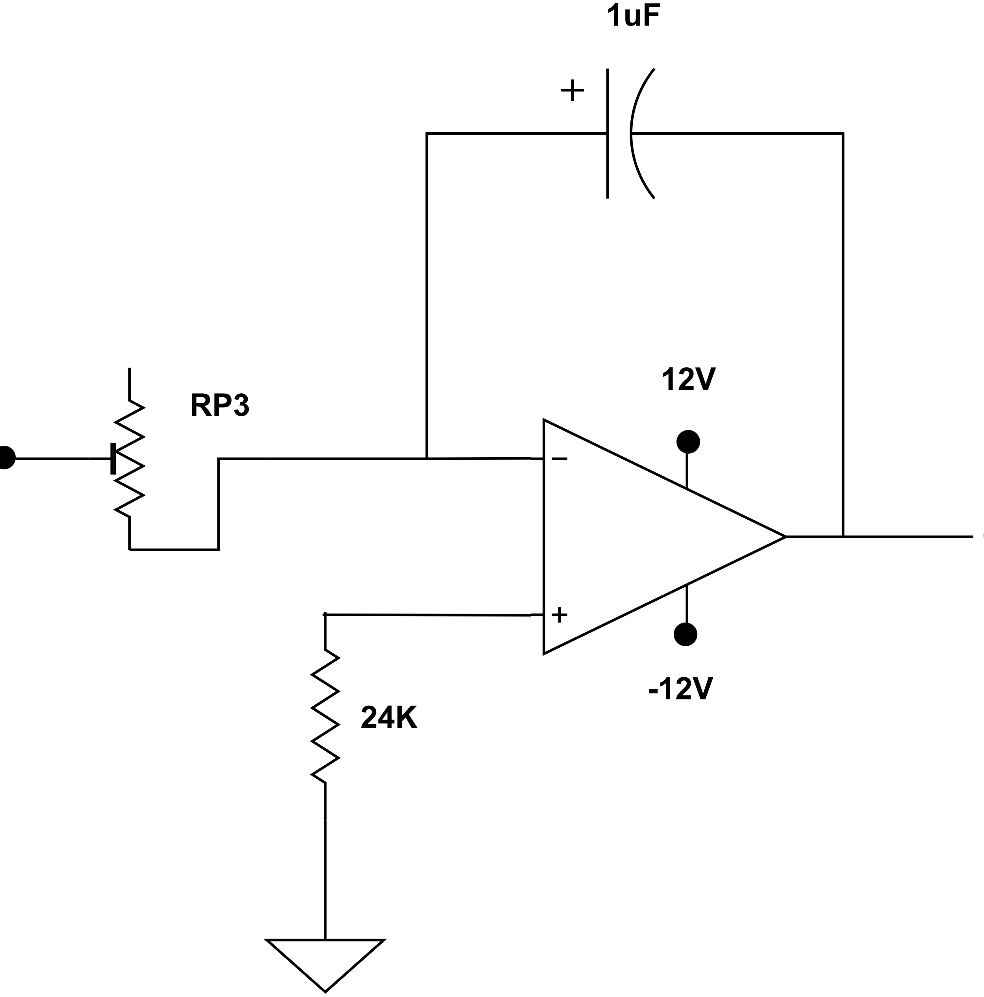
[picture p71: figure]
