dakshinatharindu/Hot-Plate/Report/PID/P.pdf

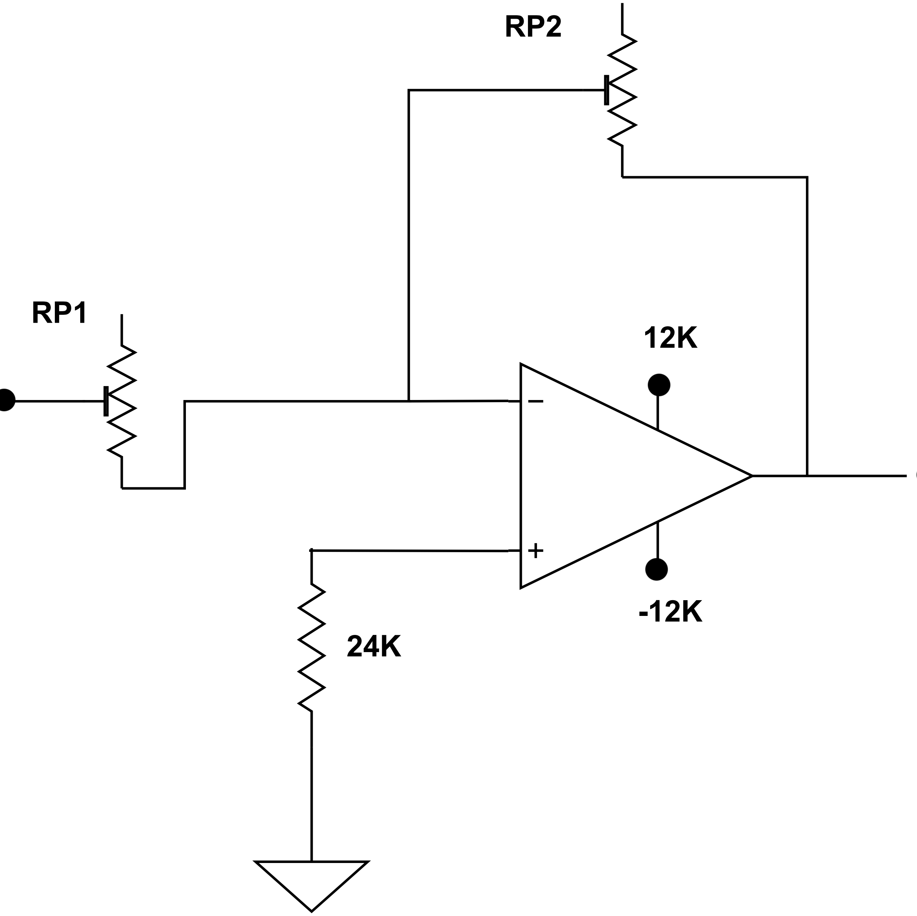
[picture p72: figure]
