dakshinatharindu/Hot-Plate/Enclosure/Renderings/IndicatorLightRender.Final Color Output20110929-17694-1cfj0jj.png

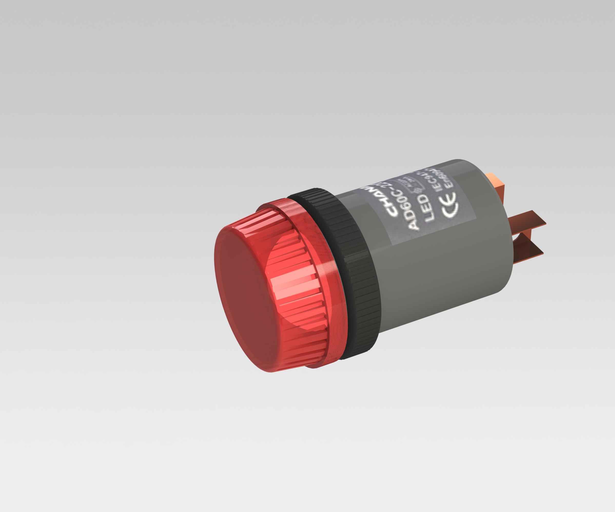
Enclosure/Renderings/IndicatorLightRender.Final Color Output20110929-17694-1cfj0jj.png
