dakshinatharindu/Hot-Plate/Enclosure/Renderings/luces panel.jpg

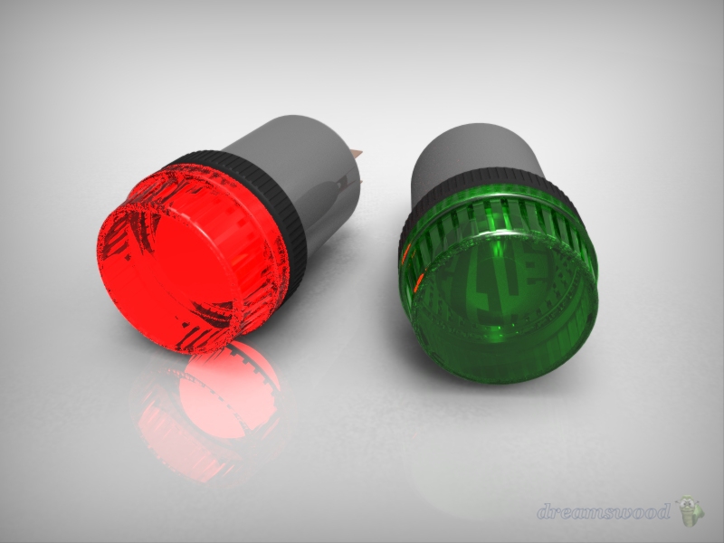
Enclosure/Renderings/luces panel.jpg
