dakshinatharindu/Hot-Plate/Enclosure/Renderings/switch20111229-5941-1tkrm6f.JPG

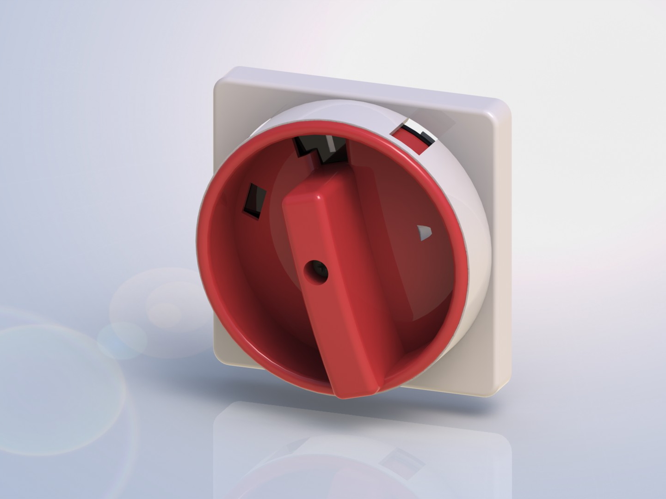
Enclosure/Renderings/switch20111229-5941-1tkrm6f.JPG
