dakshinatharindu/Hot-Plate/Enclosure/SharedScreenshot.jpg

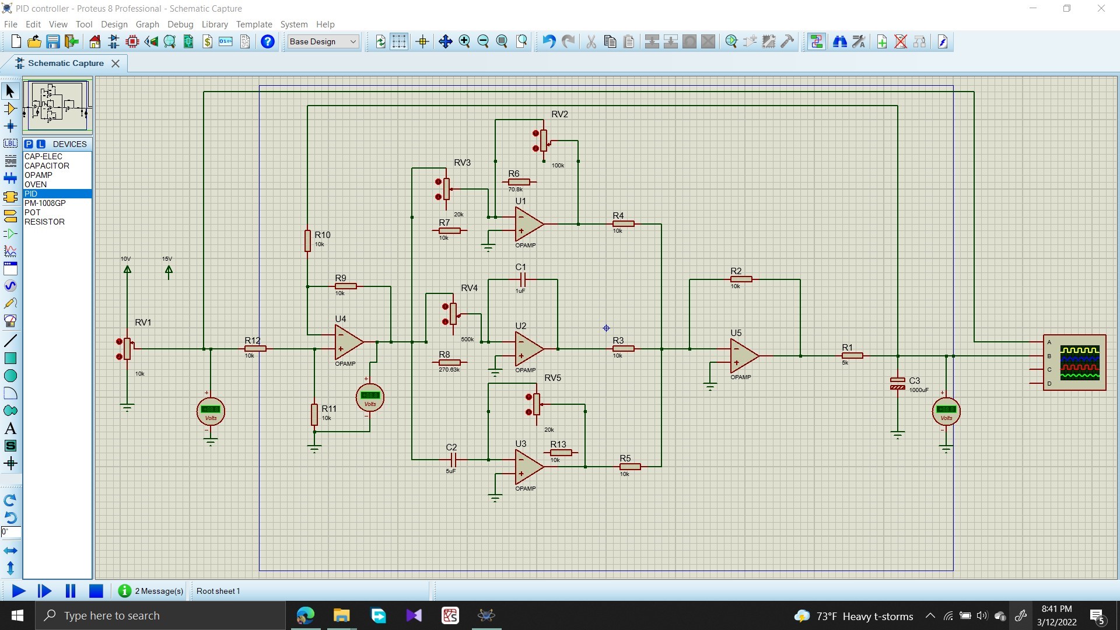
Enclosure/SharedScreenshot.jpg
