dakshinatharindu/Hot-Plate/Report/Enclosure/5c595341-cf65-4dba-9950-fa8b0f94b11d - Copy.JPG

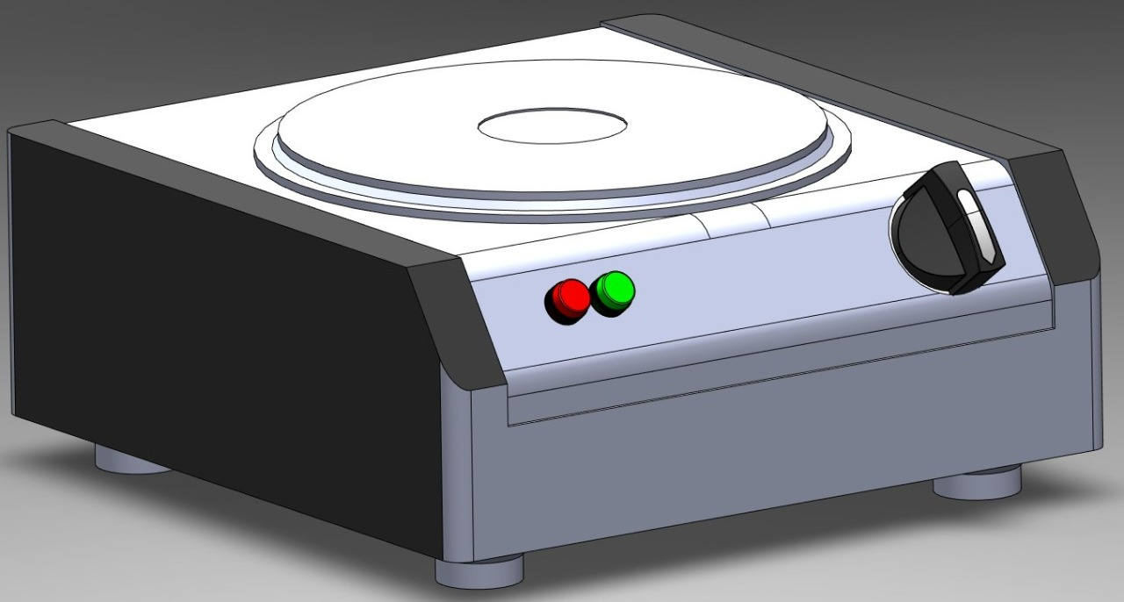
Report/Enclosure/5c595341-cf65-4dba-9950-fa8b0f94b11d - Copy.JPG
