dakshinatharindu/Hot-Plate/Report/Enclosure/1579441e-b86a-4611-8e8f-0c7dc7e0b344 - Copy.JPG

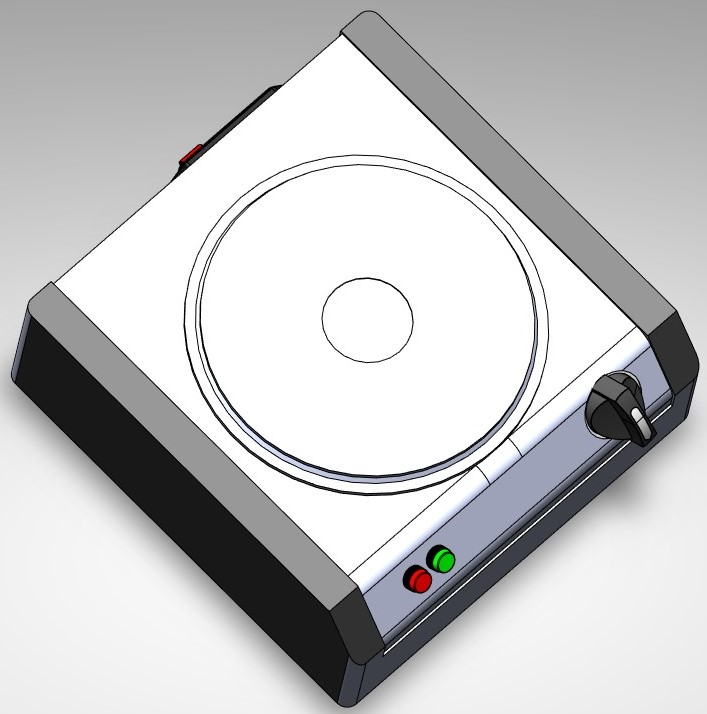
Report/Enclosure/1579441e-b86a-4611-8e8f-0c7dc7e0b344 - Copy.JPG
