dakshinatharindu/Hot-Plate/Report/IMG_20220314_160349~2.jpg

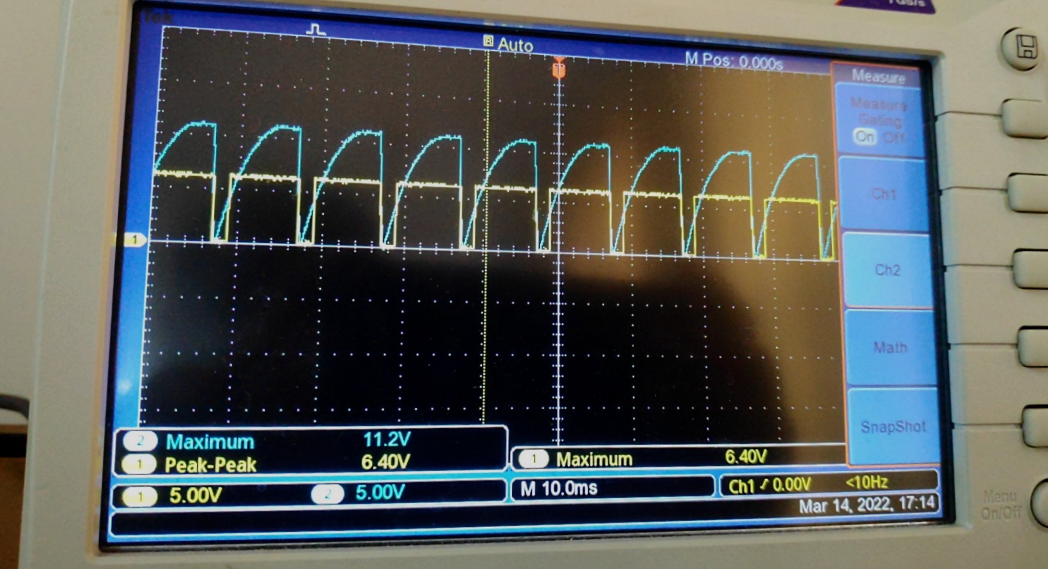
Report/IMG_20220314_160349~2.jpg
