dakshinatharindu/Hot-Plate/Report/Triac fire.jpg

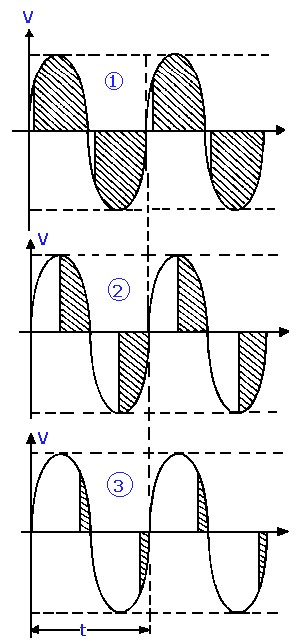
Report/Triac fire.jpg
