dakshinatharindu/Hot-Plate/Enclosure/parts.txt

Coil
wire code
switches
nobs
Led bulb
Box
plate
plug
