dakshinatharindu/Hot-Plate/Enclosure/AC-17_power_socket/Fuse_contact.SLDASM

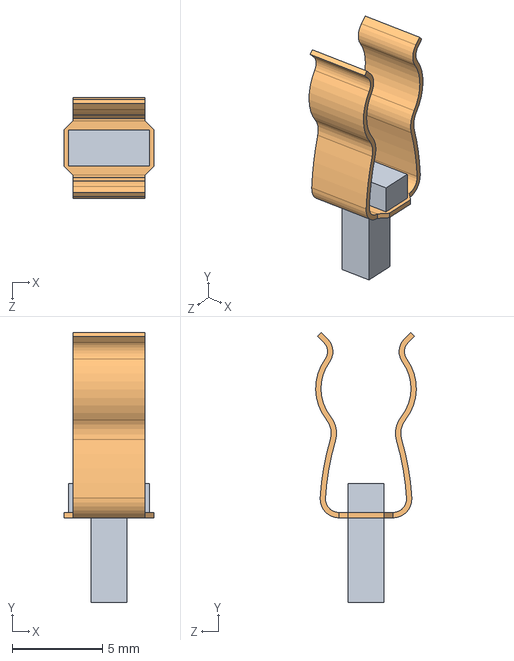
[picture p81: CAD file, 2022-03-24]
Enclosure/AC-17_power_socket/Fuse_contact.SLDASM
5.00 x 15.0 x 5.60 mm
Контакт_fuse
Fuse_holder
