dakshinatharindu/Hot-Plate/Enclosure/fnl/Assem1.SLDASM

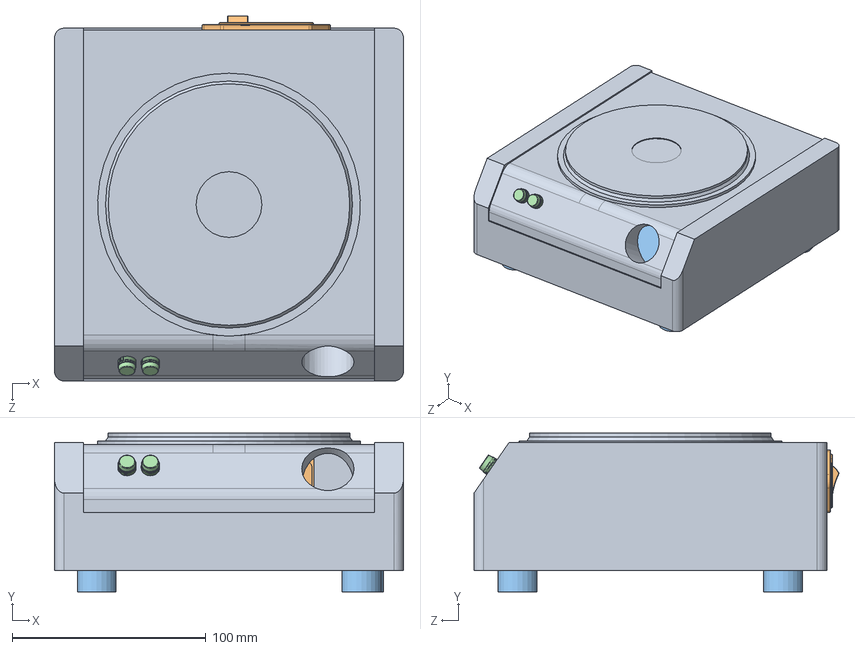
[picture p82: CAD file, 2022-03-24]
Enclosure/fnl/Assem1.SLDASM
180.0 x 82.0 x 188.2 mm
AC_Power_Socket-3_pin_250V_10A_AC-17
cover
PanelMountIndicatorLight x 2
