dakshinatharindu/Hot-Plate/Enclosure/switch1.SLDASM

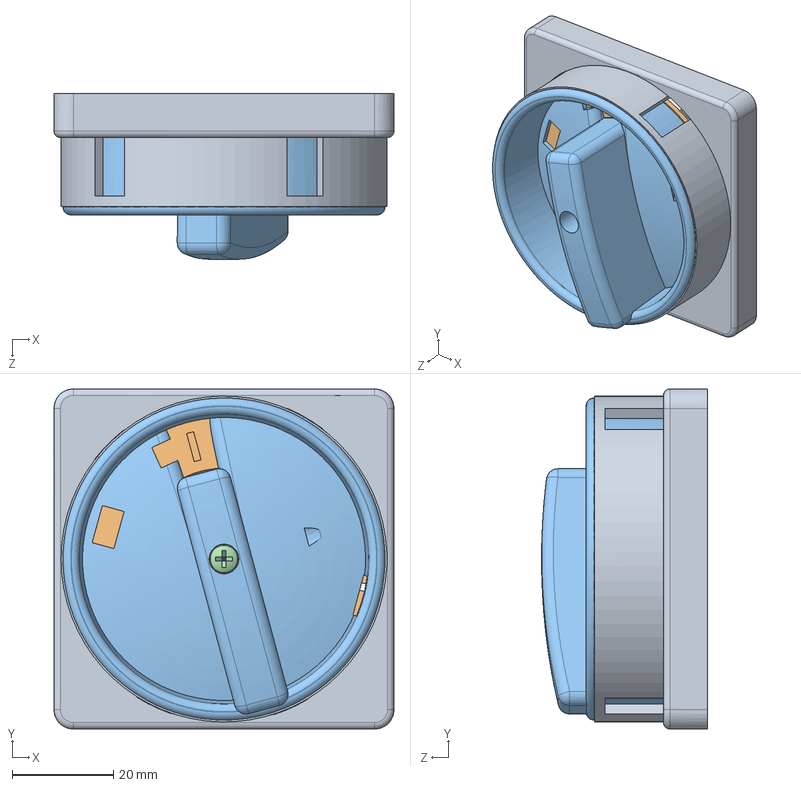
[picture p83: CAD file, 2022-03-24]
Enclosure/switch1.SLDASM
67.1 x 67.1 x 32.7 mm
cowling
indicator plate
switch dial
screw
