dakshinatharindu/Hot-Plate/Enclosure/FINAL PART.SLDASM

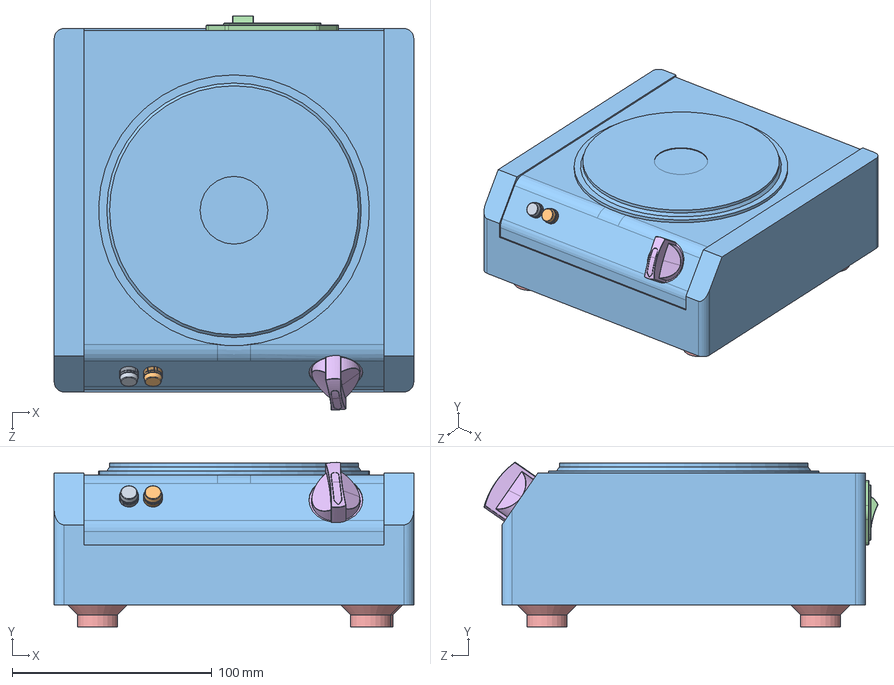
[picture p84: CAD file, 2022-03-24]
Enclosure/FINAL PART.SLDASM
180.0 x 82.4 x 197.2 mm
AC_Power_Socket-3_pin_250V_10A_AC-17
cover
PanelMountIndicatorLight
S2SR-S5W2A - Autonics.step
PanelMountIndicatorLight1
