dakshinatharindu/Hot-Plate/Enclosure/AC-17_power_socket/Держатель_предохранителя_с_предохранителем.SLDASM

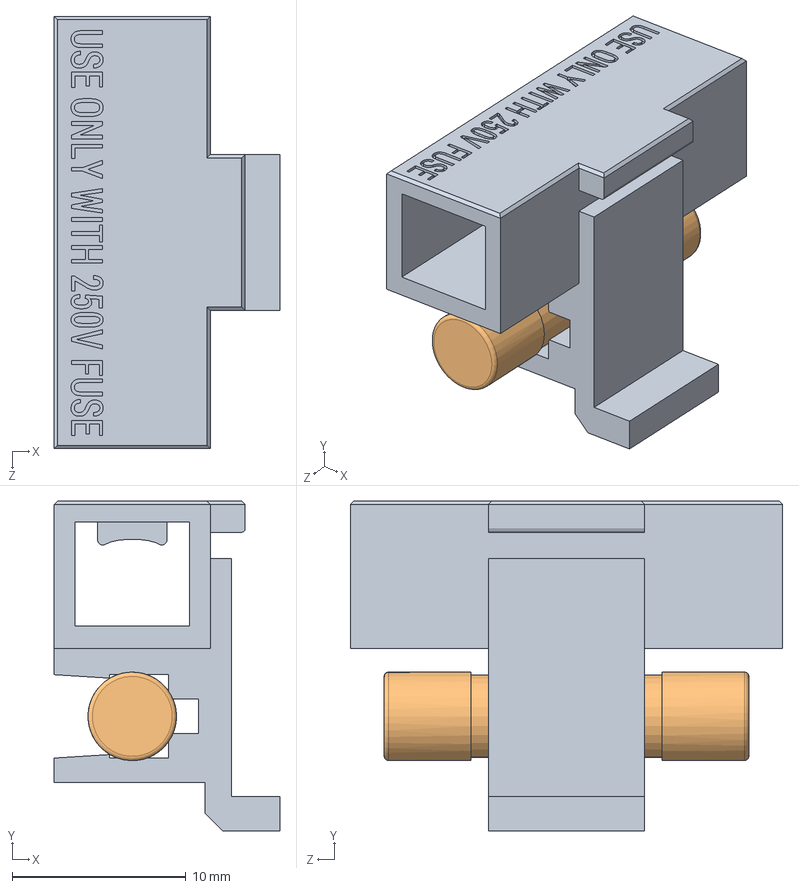
[picture p85: CAD file, 2022-03-24]
Enclosure/AC-17_power_socket/Держатель_предохранителя_с_предохранителем.SLDASM
13.0 x 19.0 x 24.9 mm
Держатель_предохранителя
Fuse Small 1A
