dakshinatharindu/Hot-Plate/Enclosure/cowling.SLDPRT

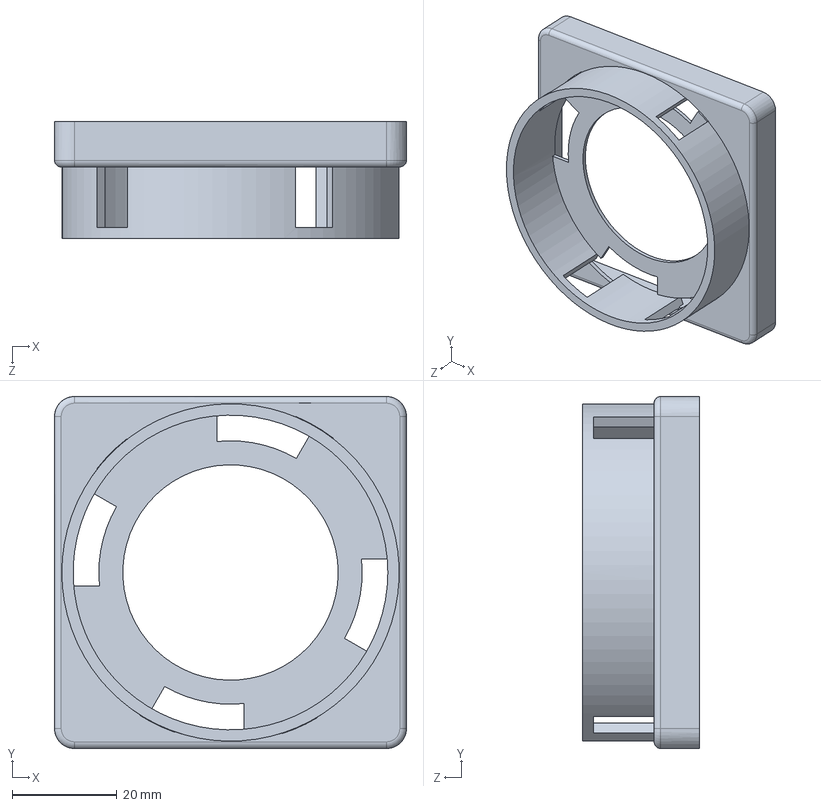
[picture p86: CAD file, 2022-03-24]
Enclosure/cowling.SLDPRT
67.1 x 67.1 x 22.3 mm
