dakshinatharindu/Hot-Plate/Enclosure/fnl/fnl part.SLDPRT

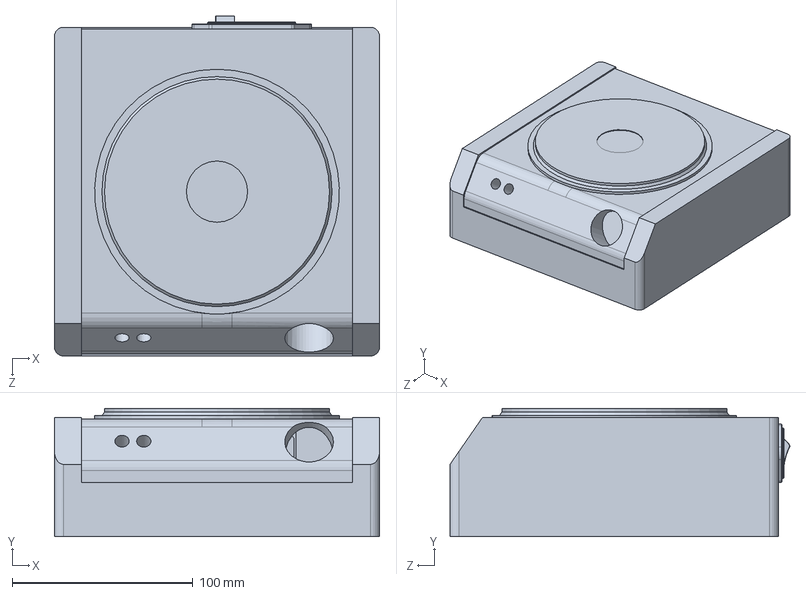
[picture p87: CAD file, 2022-03-24]
Enclosure/fnl/fnl part.SLDPRT
180.0 x 71.0 x 188.2 mm
