dakshinatharindu/Hot-Plate/Enclosure/AC-17_power_socket/Перемычка.SLDPRT

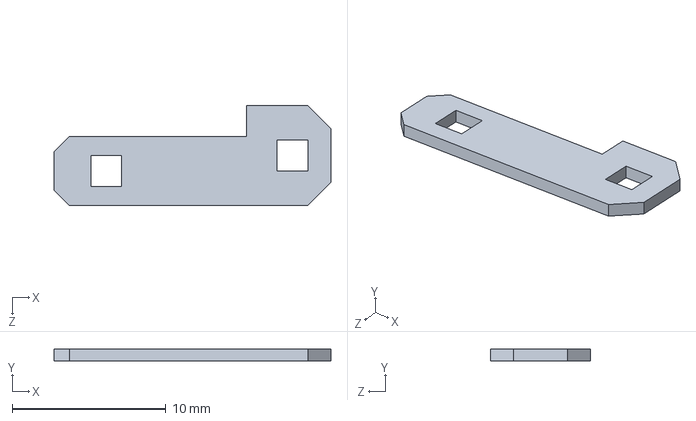
[picture p88: CAD file, 2022-03-24]
Enclosure/AC-17_power_socket/Перемычка.SLDPRT
18.0 x 0.8 x 6.50 mm
