dakshinatharindu/Hot-Plate/Enclosure/fnl/cover.SLDPRT

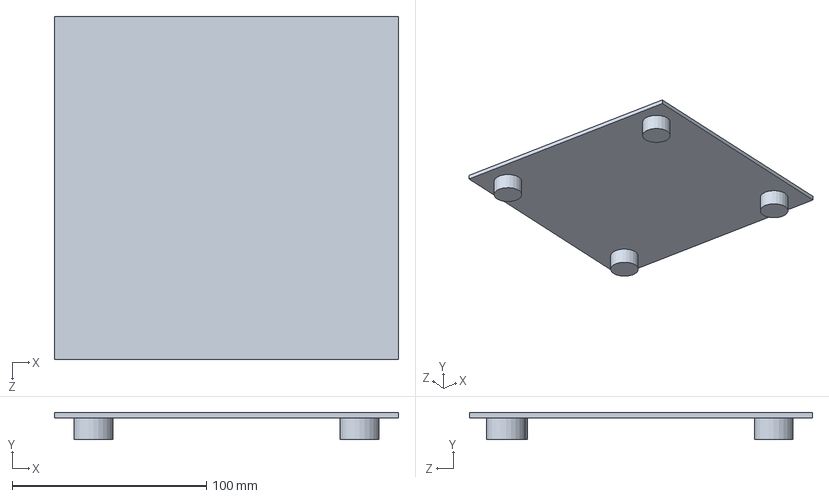
[picture p89: CAD file, 2022-03-24]
Enclosure/fnl/cover.SLDPRT
176.9 x 14.0 x 176.5 mm
