dakshinatharindu/Hot-Plate/Enclosure/indicator plate.SLDPRT

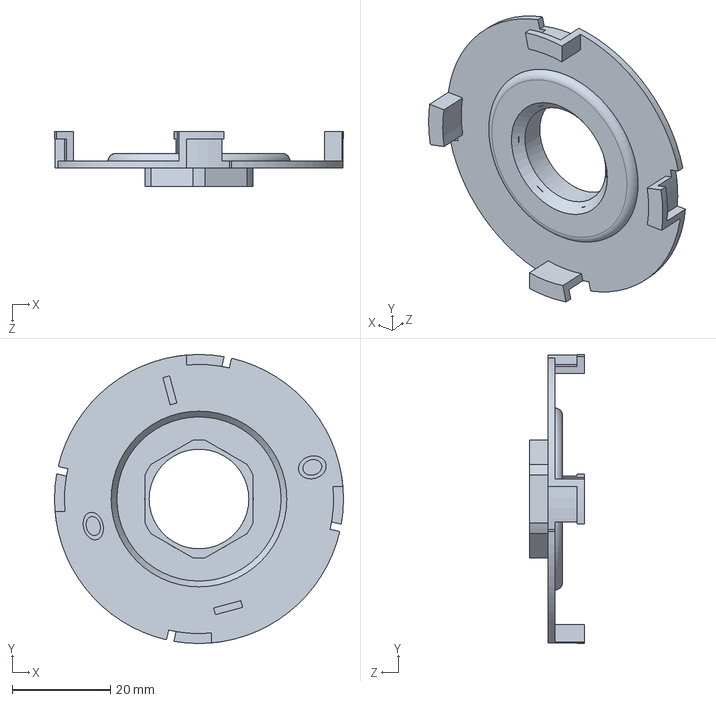
[picture p90: CAD file, 2022-03-24]
Enclosure/indicator plate.SLDPRT
58.9 x 58.9 x 11.1 mm
