dakshinatharindu/Hot-Plate/Enclosure/AC-17_power_socket/Держатель_предохранителя.SLDPRT

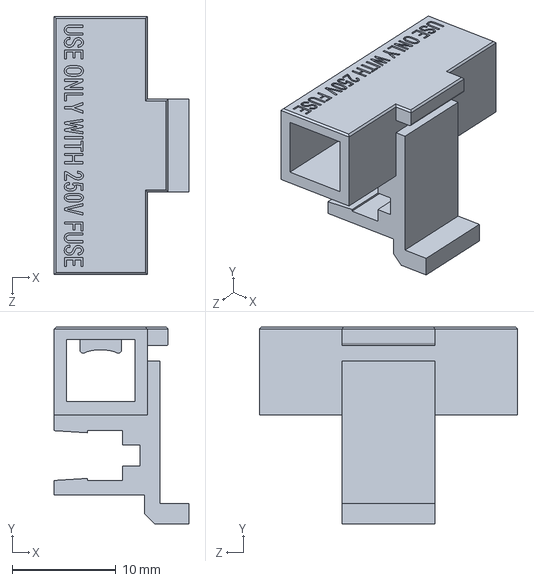
[picture p91: CAD file, 2022-03-24]
Enclosure/AC-17_power_socket/Держатель_предохранителя.SLDPRT
13.0 x 19.0 x 24.9 mm
