dakshinatharindu/Hot-Plate/Enclosure/AC_Power_Socket-3_pin_250V_10A_AC-17.STEP

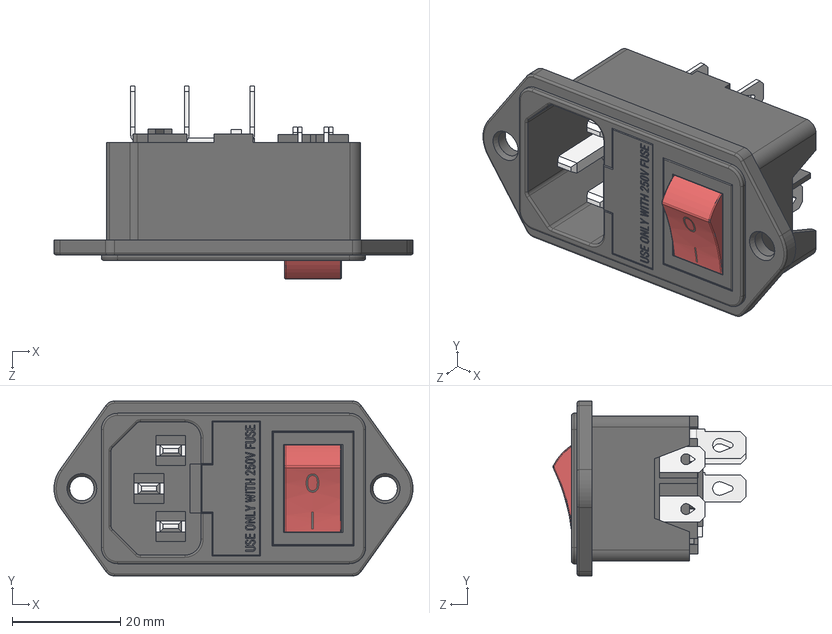
[picture p92: CAD file, 2022-03-24]
Enclosure/AC_Power_Socket-3_pin_250V_10A_AC-17.STEP
66.3 x 32.3 x 35.6 mm
Case_PC
Êîíòàêò x 2
扻艜魛瀖GND
抔樥憵 x 3
扻艜魛瀖fuse x 2
Fuse_holder x 2
Ïåðåìû÷êà
SWITCH KCD1-104_Default<As Machined>
Äåðæàòåëü_ïðåäîõðàíèòåëÿ
Fuse Small 1A
