dakshinatharindu/Hot-Plate/Enclosure/AC-17_power_socket/Клейма.SLDPRT

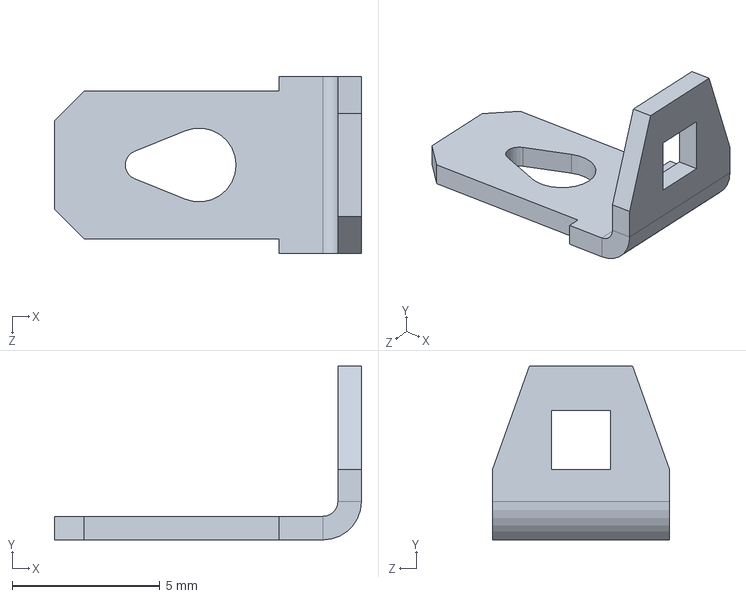
[picture p93: CAD file, 2022-03-24]
Enclosure/AC-17_power_socket/Клейма.SLDPRT
10.4 x 5.89 x 6.00 mm
