dakshinatharindu/Hot-Plate/Enclosure/PanelMountIndicatorLight1.SLDPRT

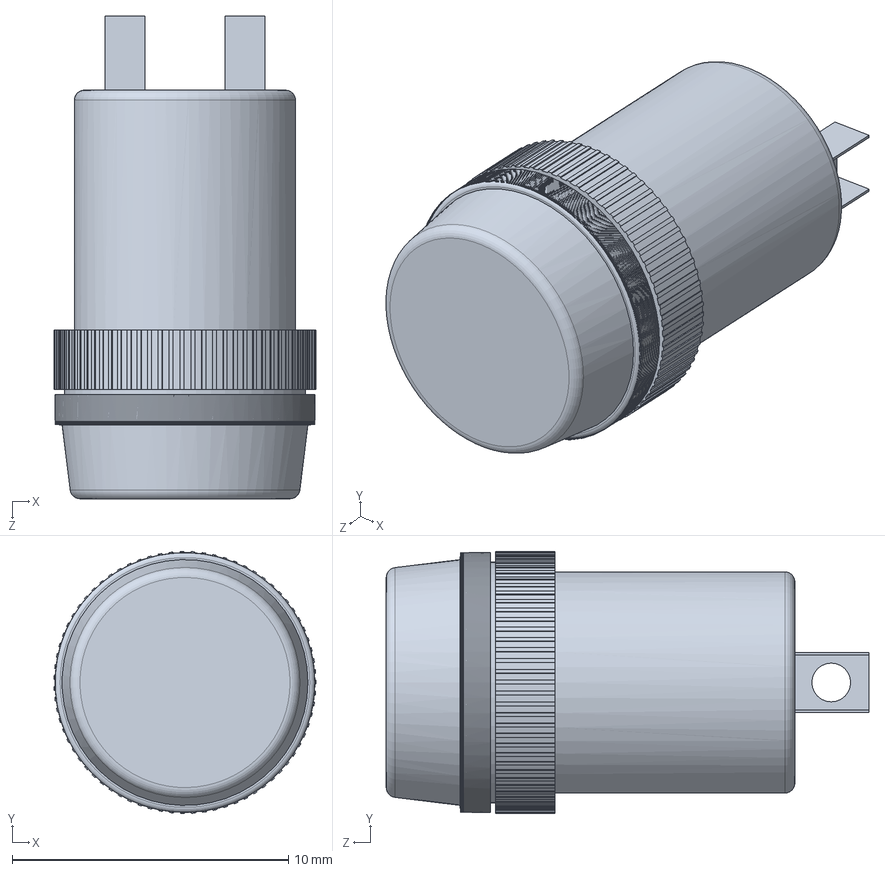
[picture p94: CAD file, 2022-03-24]
Enclosure/PanelMountIndicatorLight1.SLDPRT
9.48 x 9.48 x 17.5 mm
