dakshinatharindu/Hot-Plate/Enclosure/AC-17_power_socket/Fuse_holder.SLDPRT

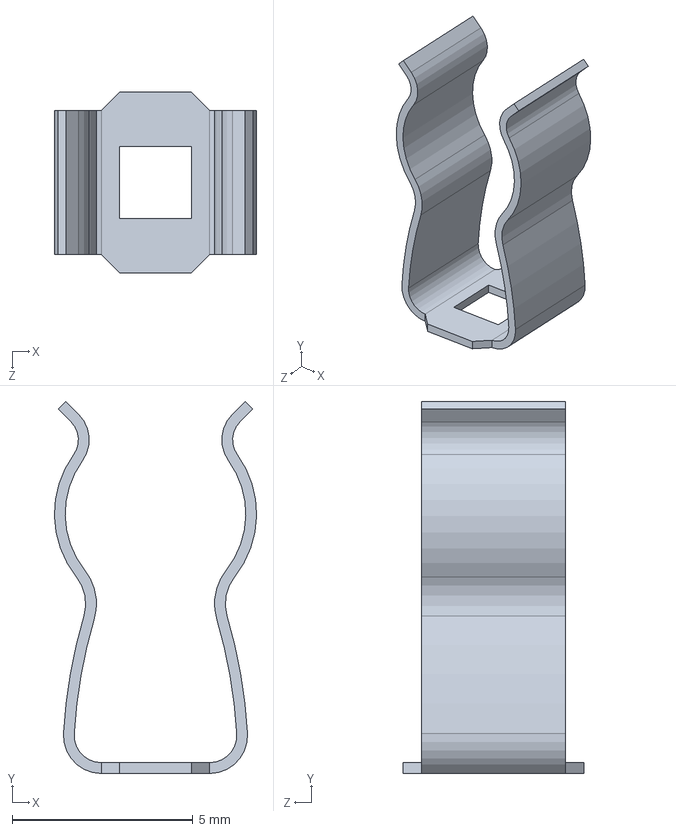
[picture p95: CAD file, 2022-03-24]
Enclosure/AC-17_power_socket/Fuse_holder.SLDPRT
5.60 x 10.3 x 5.00 mm
