dakshinatharindu/Hot-Plate/Enclosure/switch dial.SLDPRT

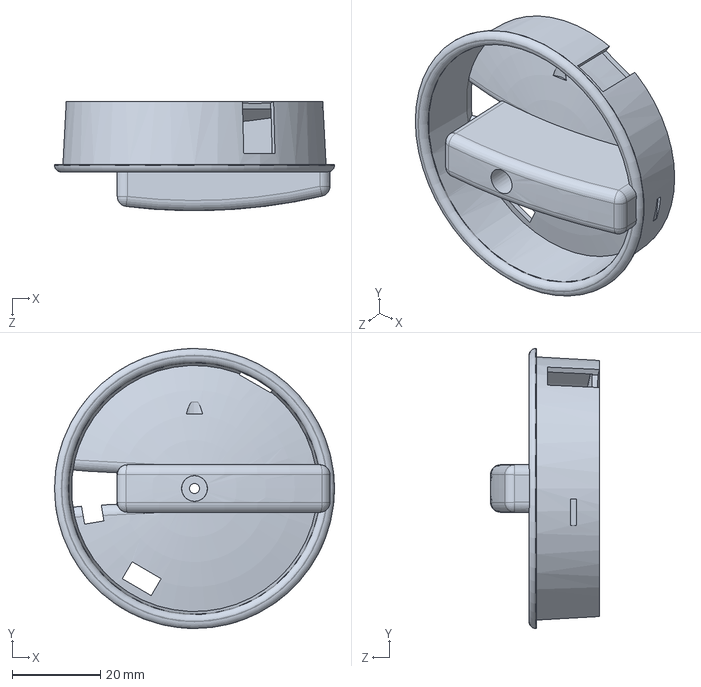
[picture p96: CAD file, 2022-03-24]
Enclosure/switch dial.SLDPRT
63.5 x 63.5 x 24.8 mm
