dakshinatharindu/Hot-Plate/Enclosure/Part1.SLDPRT

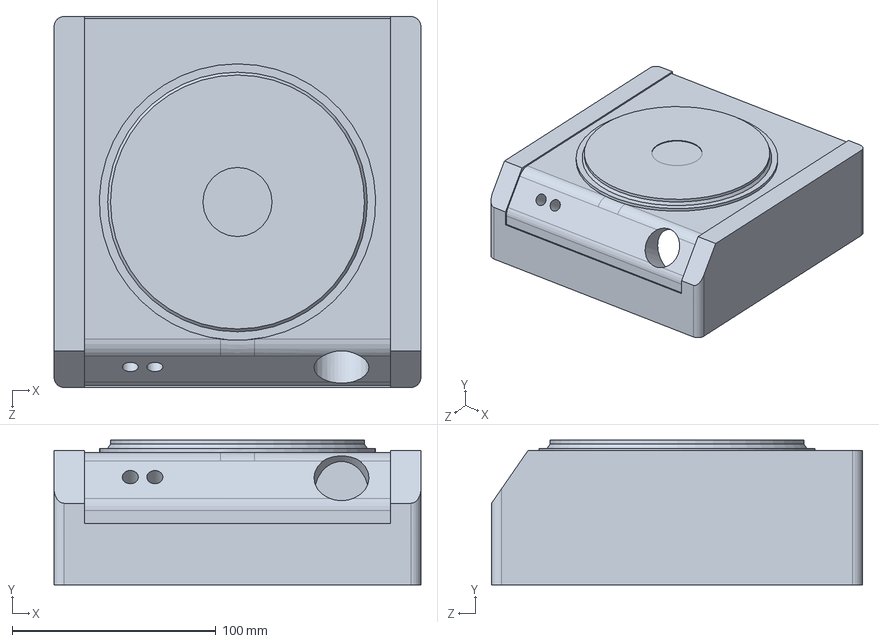
[picture p97: CAD file, 2022-03-24]
Enclosure/Part1.SLDPRT
180.0 x 71.0 x 182.0 mm
