dakshinatharindu/Hot-Plate/Enclosure/AC-17_power_socket/Контакт.SLDPRT

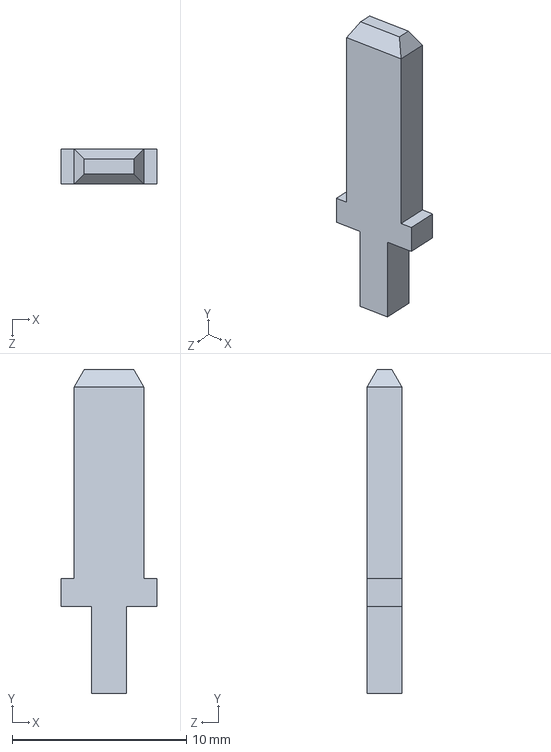
[picture p98: CAD file, 2022-03-24]
Enclosure/AC-17_power_socket/Контакт.SLDPRT
5.50 x 18.6 x 2.00 mm
