dakshinatharindu/Hot-Plate/Enclosure/AC-17_power_socket/Fuse Small 1A.SLDPRT

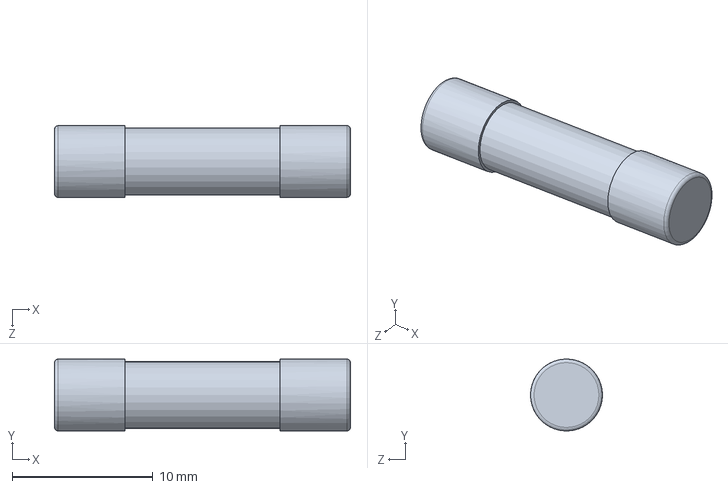
[picture p99: CAD file, 2022-03-24]
Enclosure/AC-17_power_socket/Fuse Small 1A.SLDPRT
21.0 x 5.10 x 5.10 mm
