dakshinatharindu/Hot-Plate/Enclosure/AC-17_power_socket/SWITCH KCD1-104.SLDPRT

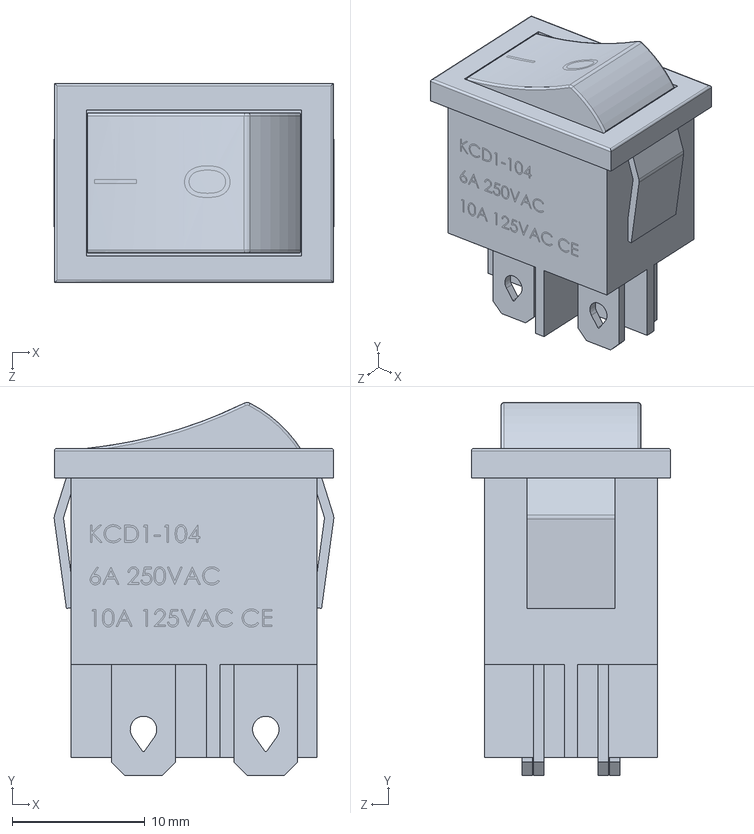
[picture p100: CAD file, 2022-03-24]
Enclosure/AC-17_power_socket/SWITCH KCD1-104.SLDPRT
21.0 x 28.1 x 15.0 mm
