dakshinatharindu/Hot-Plate/Enclosure/AC-17_power_socket/Контакт_GND.SLDPRT

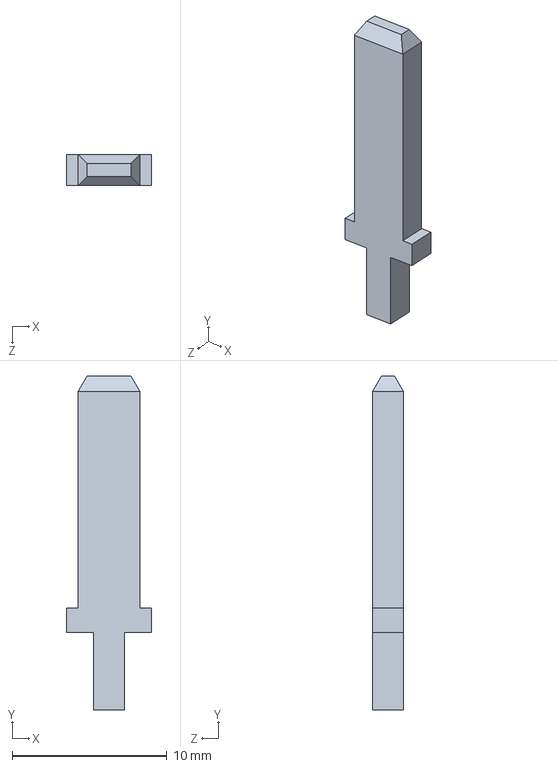
[picture p101: CAD file, 2022-03-24]
Enclosure/AC-17_power_socket/Контакт_GND.SLDPRT
5.50 x 21.6 x 2.00 mm
