dakshinatharindu/Hot-Plate/Enclosure/AC-17_power_socket/Контакт_fuse.SLDPRT

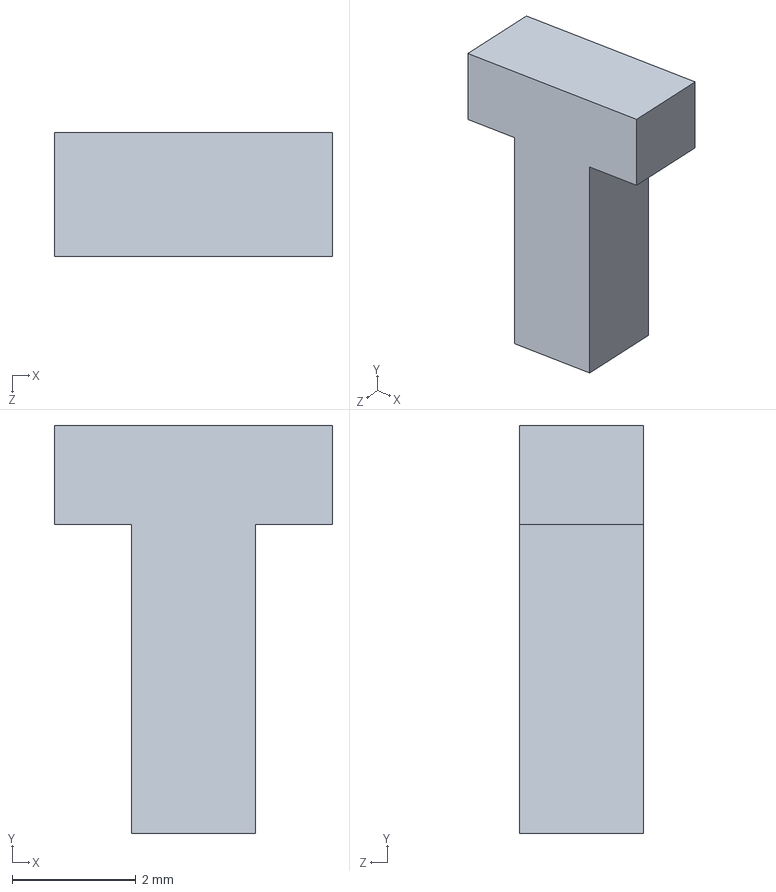
[picture p102: CAD file, 2022-03-24]
Enclosure/AC-17_power_socket/Контакт_fuse.SLDPRT
4.50 x 6.60 x 2.00 mm
