dakshinatharindu/Hot-Plate/Enclosure/AC-17_power_socket/Case_PC.SLDPRT

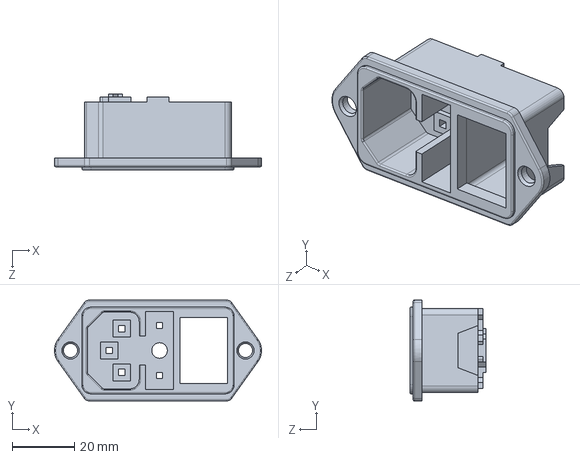
[picture p103: CAD file, 2022-03-24]
Enclosure/AC-17_power_socket/Case_PC.SLDPRT
66.3 x 32.3 x 24.3 mm
