dakshinatharindu/Hot-Plate/(list of files, cad)

Other CAD files:
Enclosure/PanelMountIndicatorLight.SLDPRT
Enclosure/Hot plate box.SLDPRT
Enclosure/AC_Power_Socket-3_pin_250V_10A_AC-17.IGS
Enclosure/AC_Power_Socket-3_pin_250V_10A_AC-17.SLDPRT
Enclosure/screw.SLDPRT
