dakshinatharindu/Hot-Plate/Report/Introduction/PiD .pdf

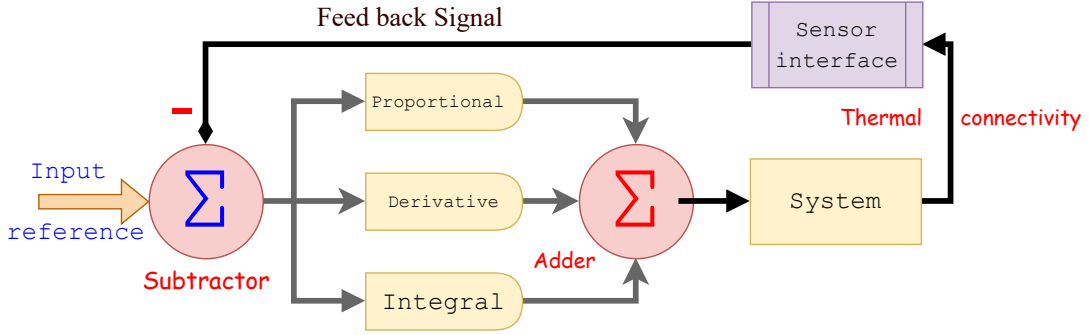
[picture p104: page 1]
Input; reference; Integral; Proportional; Derivative; Thermal; connectivity; System; Sensor interface; Adder; Subtractor

Feed back Signal
