dakshinatharindu/Hot-Plate/Report/Method/Block diagram.pdf

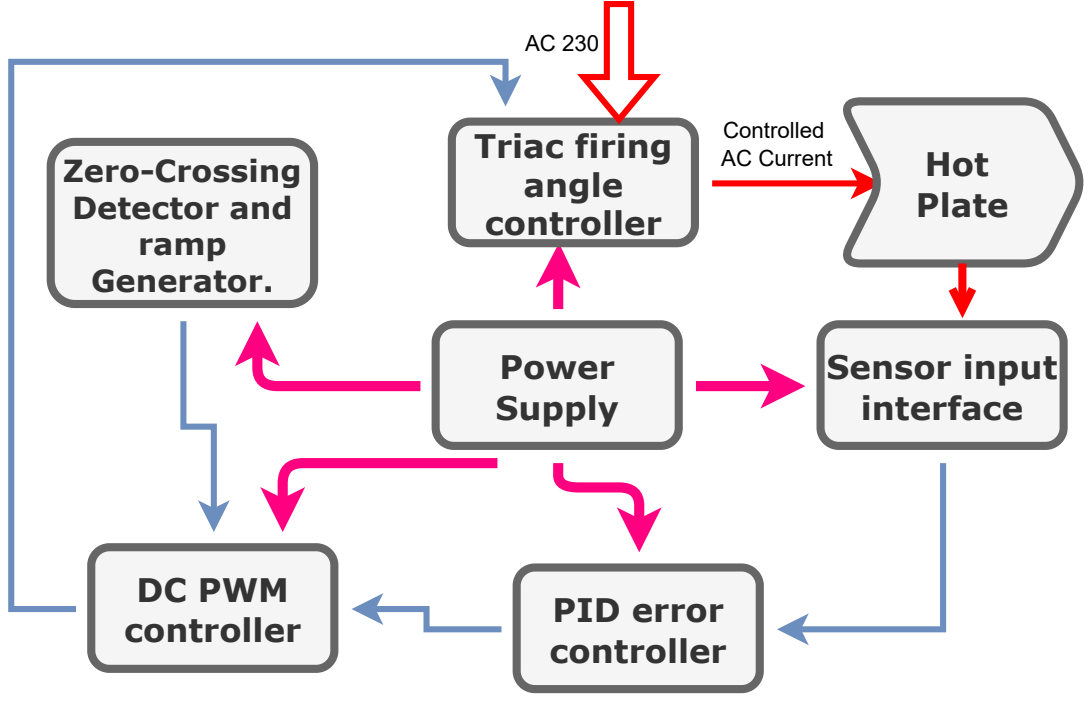
[picture p105: page 1]
Power Supply; Zero-Crossing Detector and ramp Generator.; PID error controller; Sensor input interface; Controlled Triac firing; AC Current; angle controller; DC PWM controller; Hot Plate
