dakshinatharindu/Hot-Plate/Report/Method/Power supply.pdf

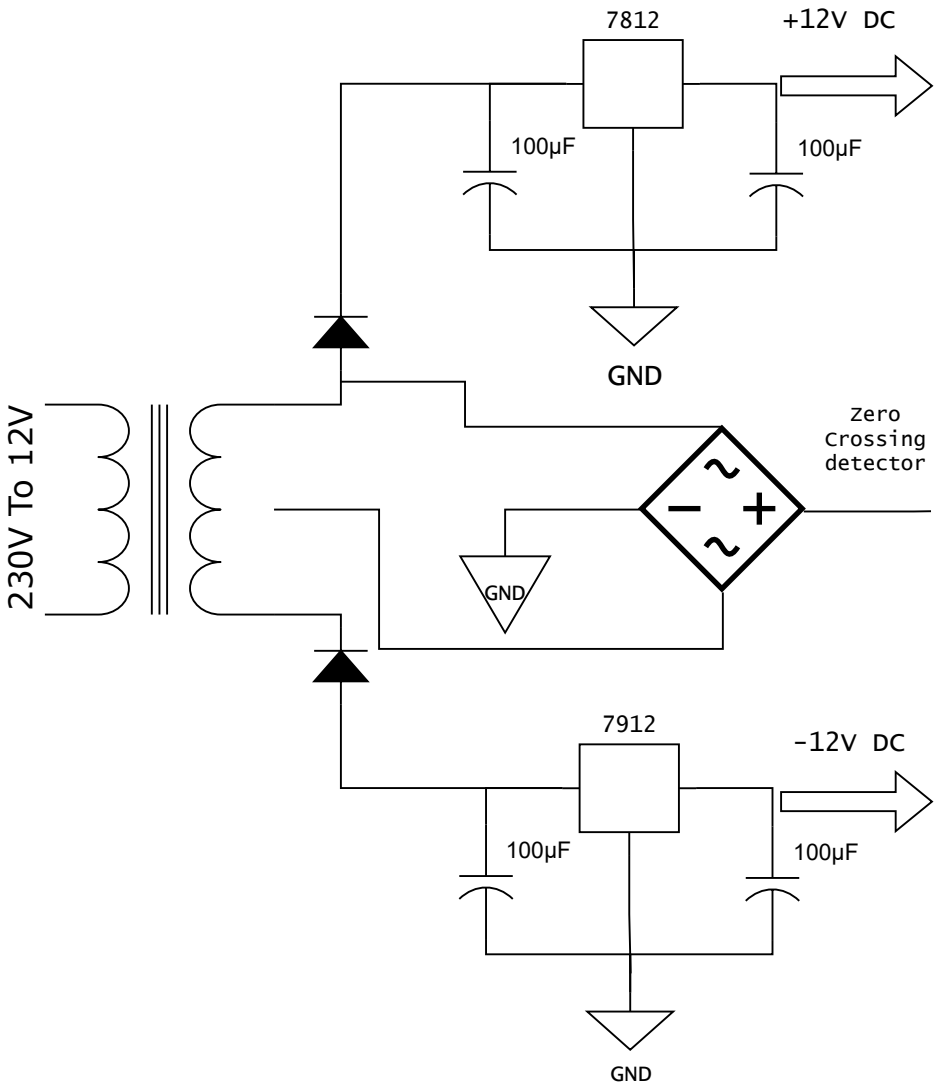
[picture p106: page 1]
Zero Crossing detector; GND
