dakshinatharindu/Hot-Plate/Report/Method/pt100 curve.pdf

# Linear curve

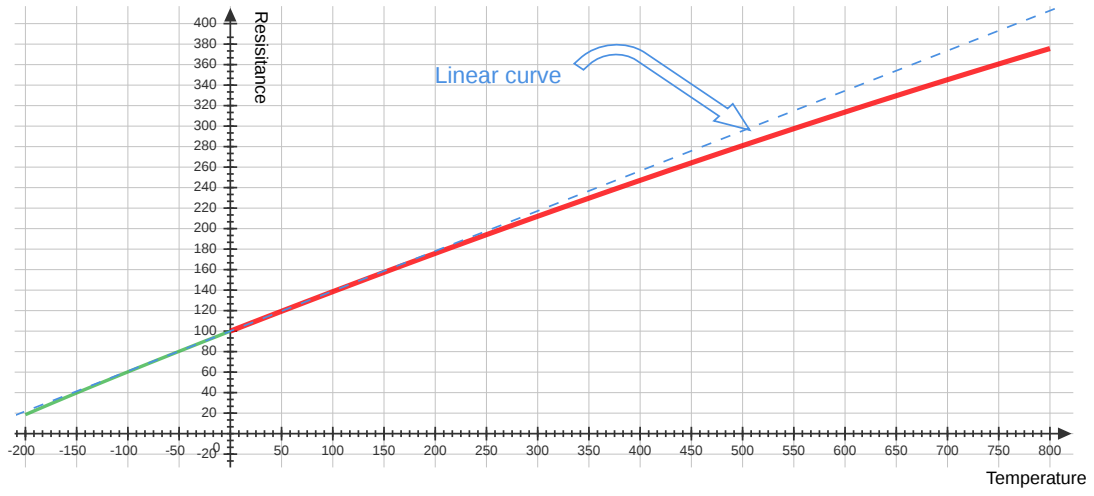
[picture p107: page 1]
Temperature; Resisitance
