dakshinatharindu/Hot-Plate/Report/Method/Triac Cct.pdf

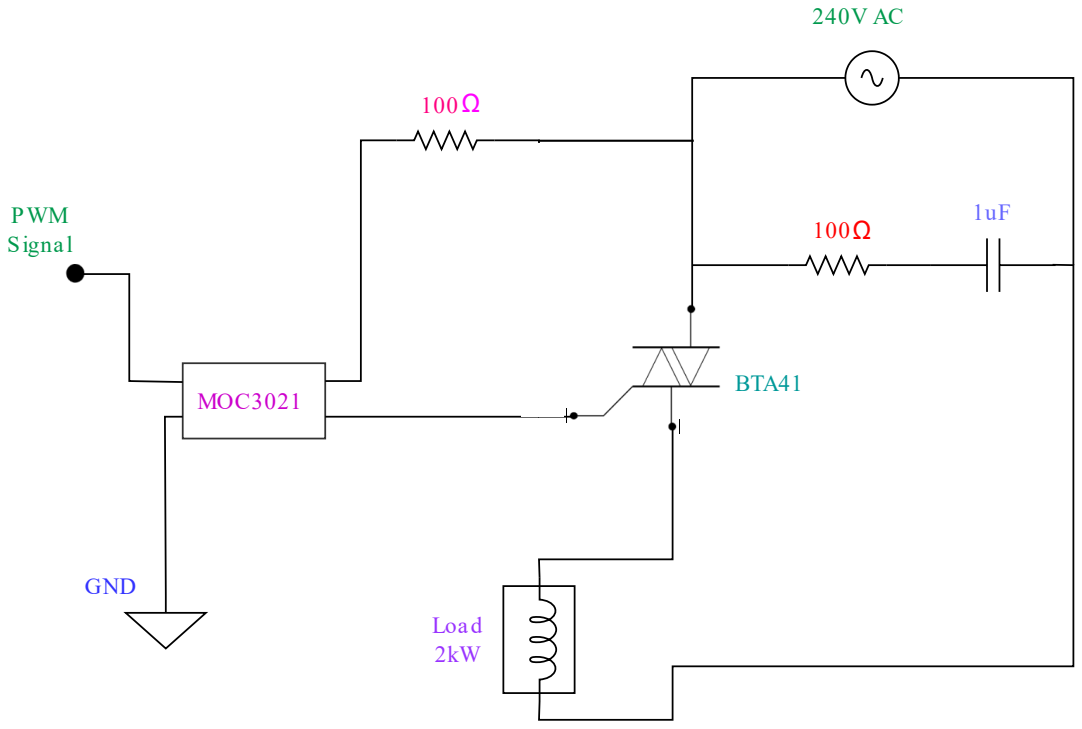
[picture p108: page 1]
PWM Signa l; GND; Load 2kW; BTA41; MOC3021
