dakshinatharindu/Hot-Plate/Report/Method/Ze_Area Pluse.drawio.pdf

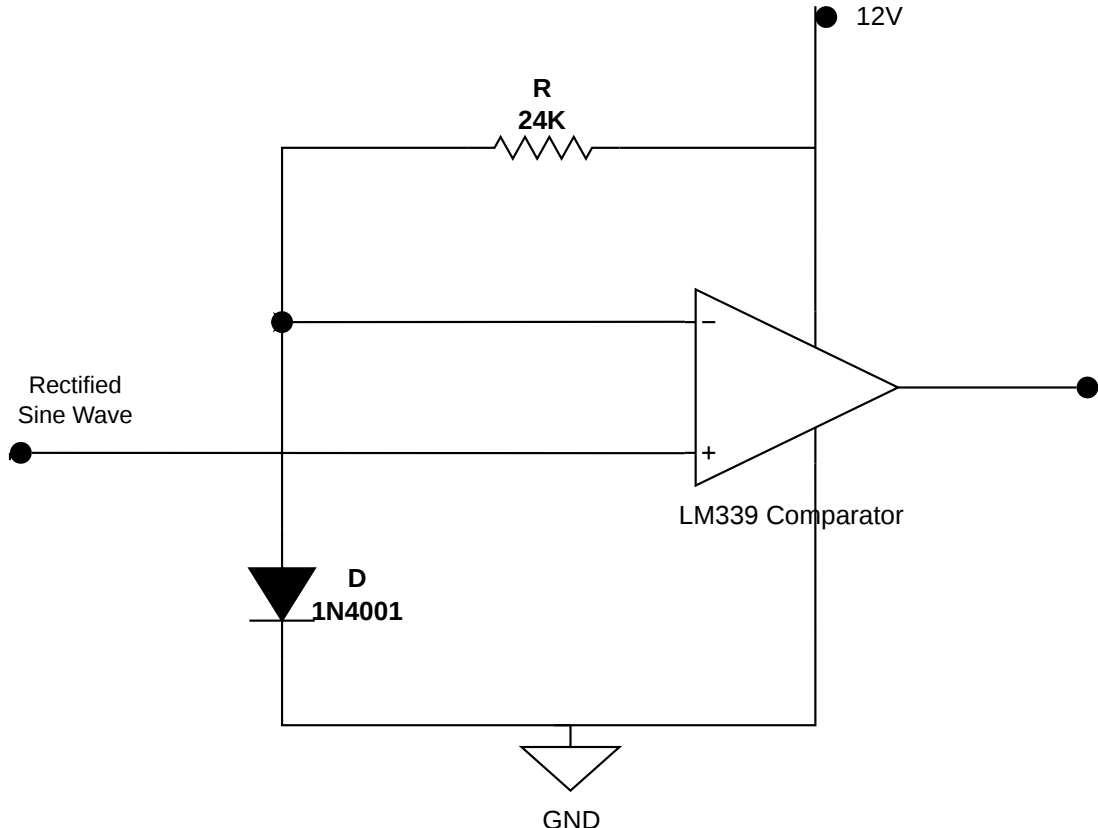
[picture p109: page 1]
LM339 Comparator; Rectified Sine Wave; GND
