dakshinatharindu/Hot-Plate/Report/PCB fabricated/proteus.pdf

TR1
BR1

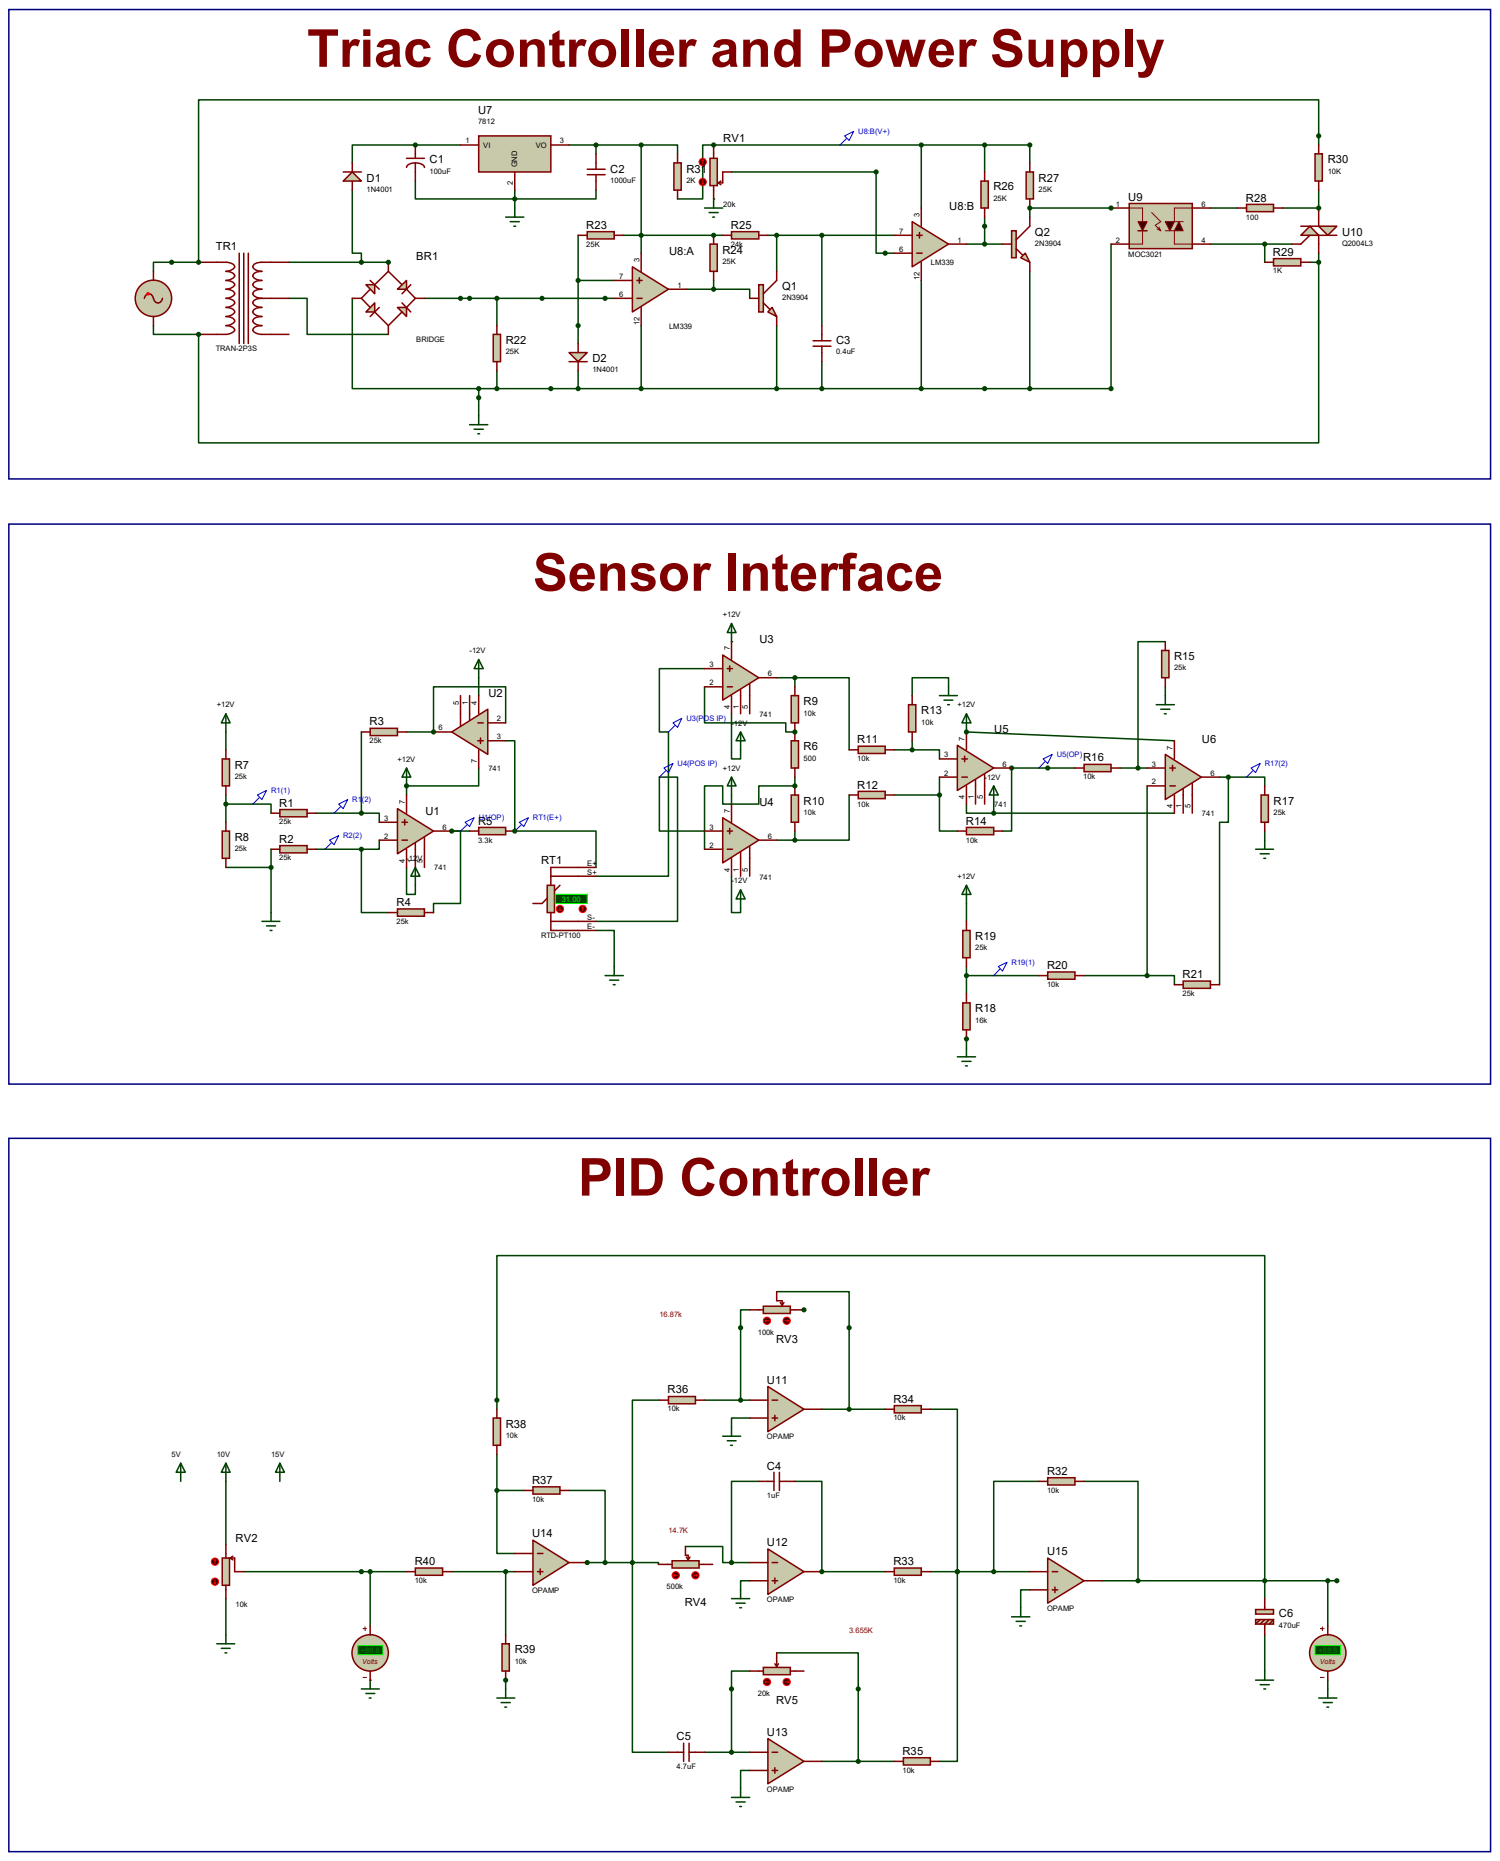
[picture p110: page 1]

Triac Controller and Power Supply
