dakshinatharindu/Hot-Plate/Report/Method/PT100 graph.pdf

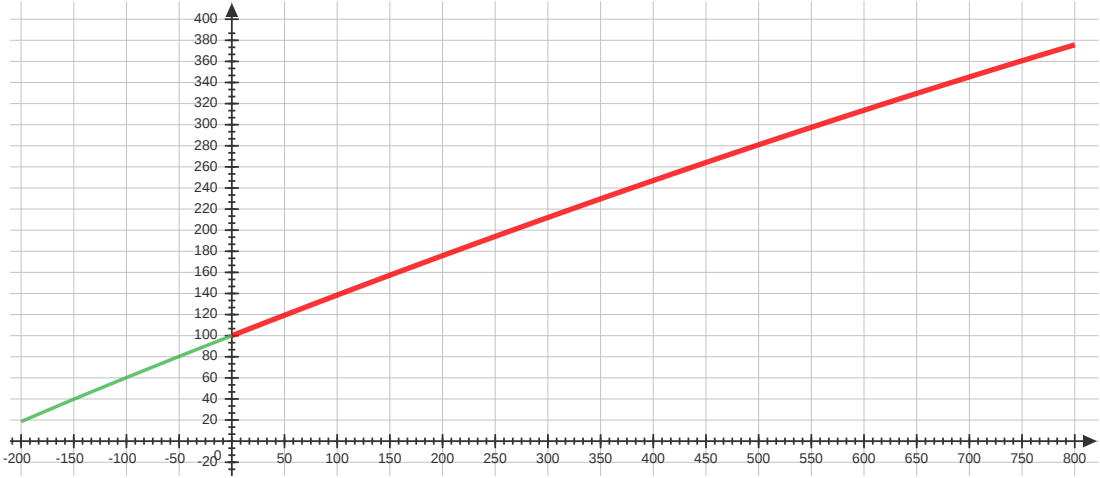
[picture p125: page 1]
