dakshinatharindu/Hot-Plate/Report/Method/PWM Genration from ramp graph.pdf

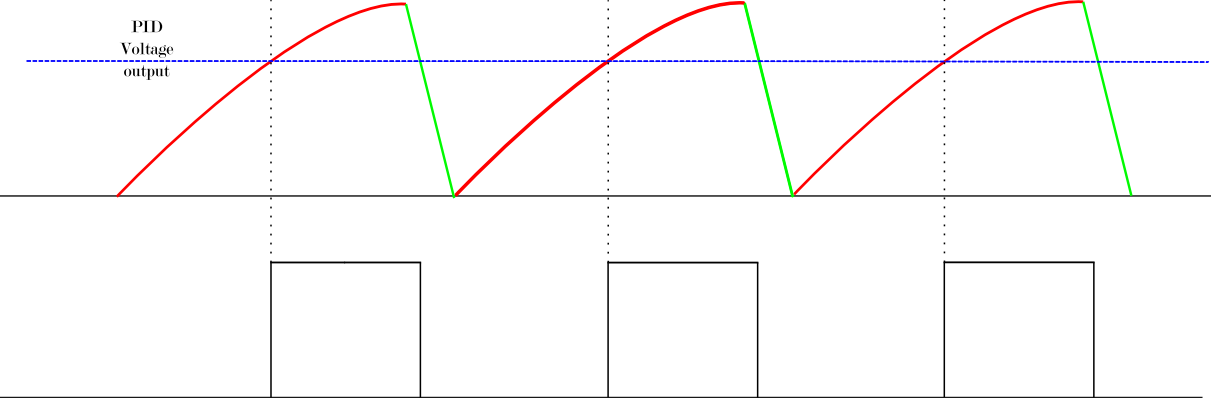
[picture p126: page 1]
