dakshinatharindu/Hot-Plate/Report/Method/Zero-ramp function.pdf

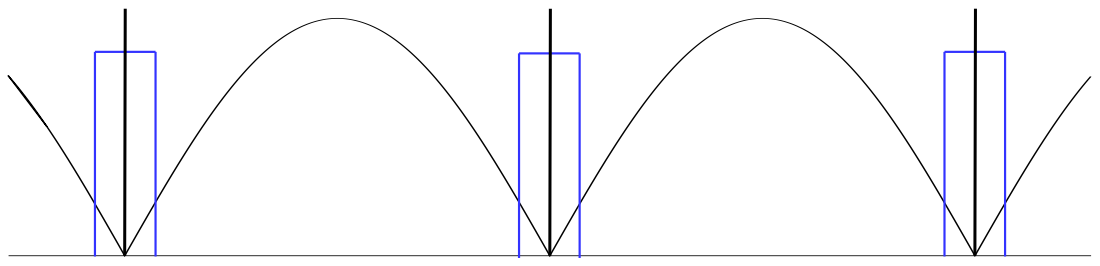
[picture p127: page 1]
