dakshinatharindu/Hot-Plate/Report/PCB fabricated/PCB1.pdf

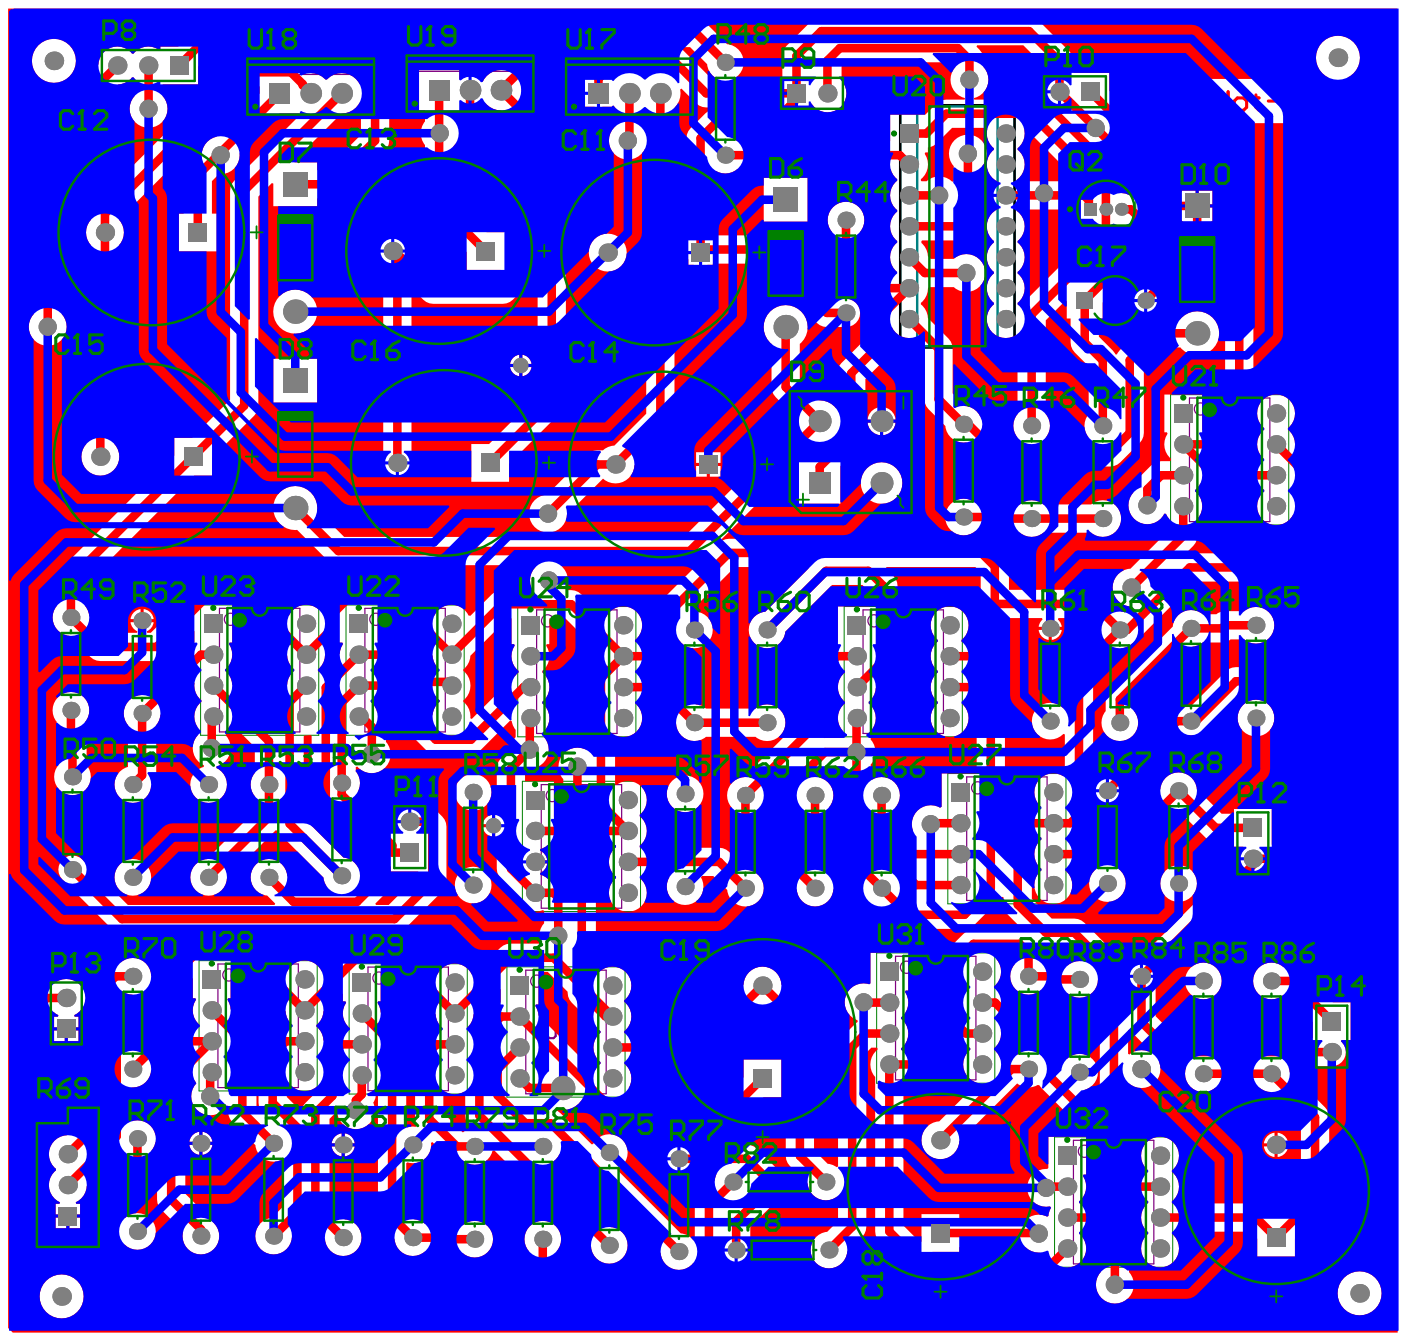
[picture p128: page 1]
