dakshinatharindu/Hot-Plate/Report/PCB fabricated/PCB2.pdf

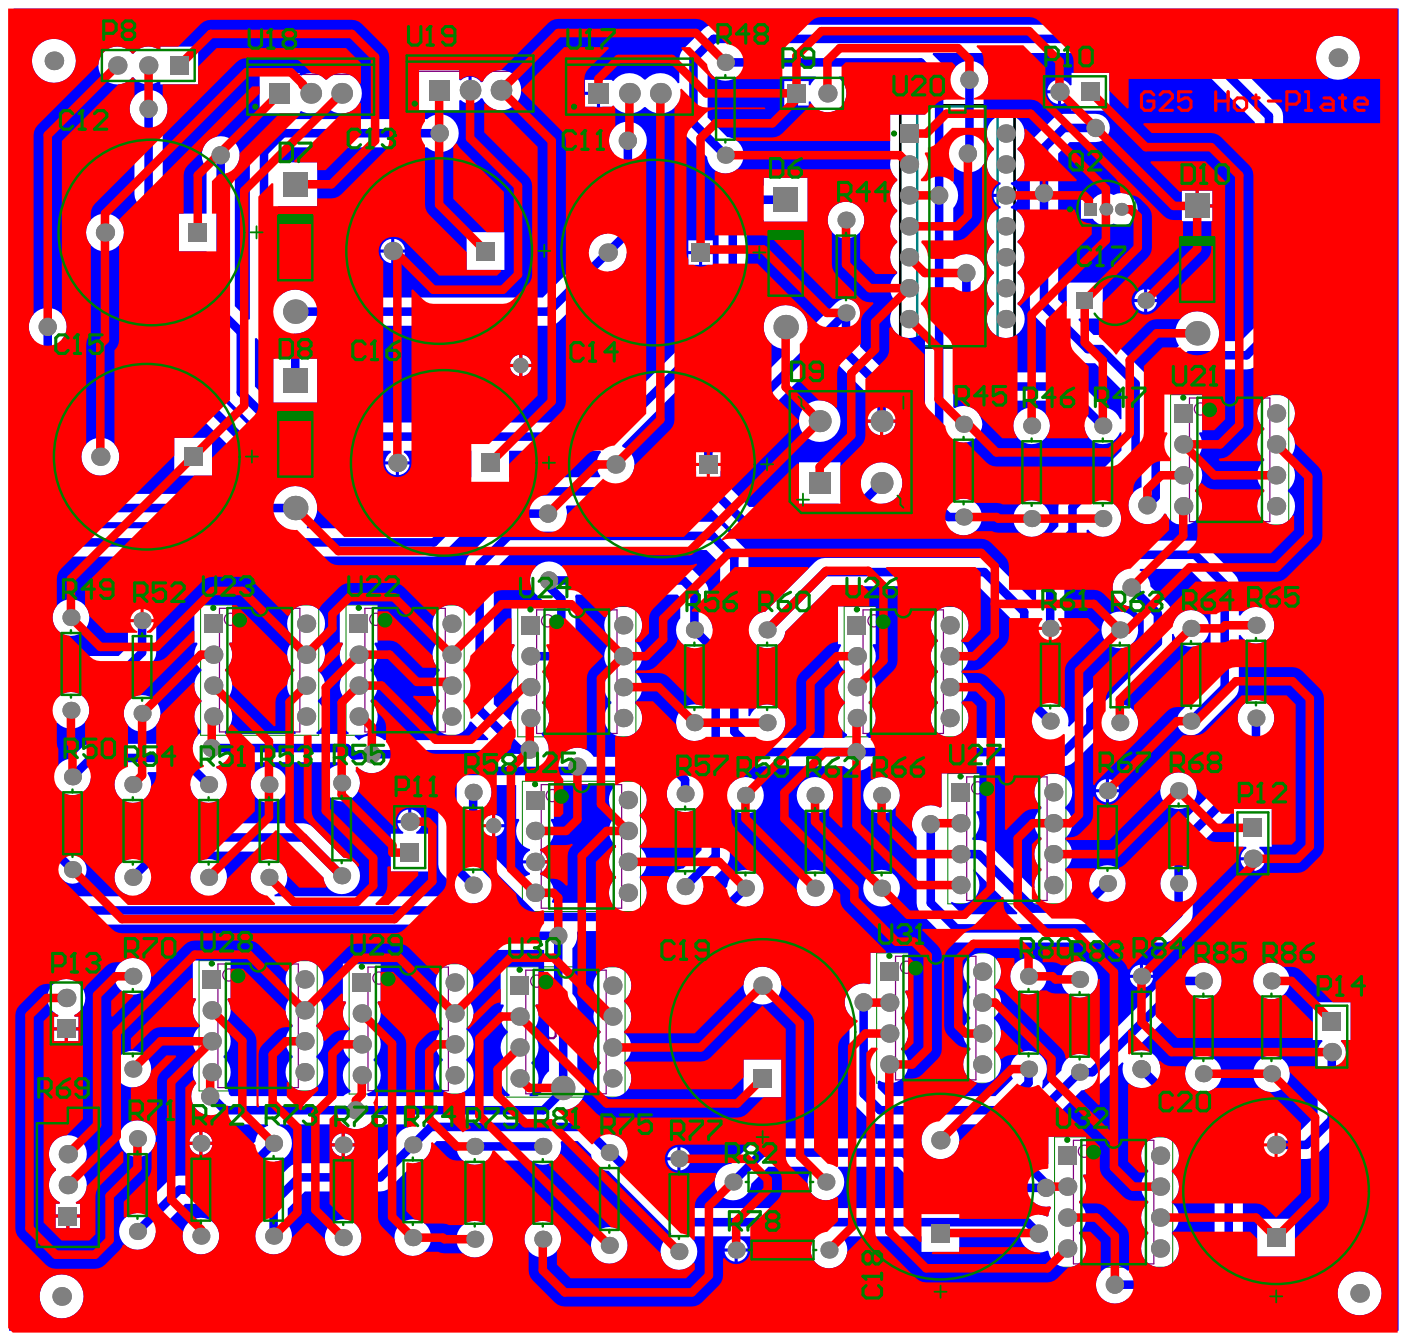
[picture p129: page 1]
