dakshinatharindu/Hot-Plate/Report/PCB fabricated/schematic.pdf

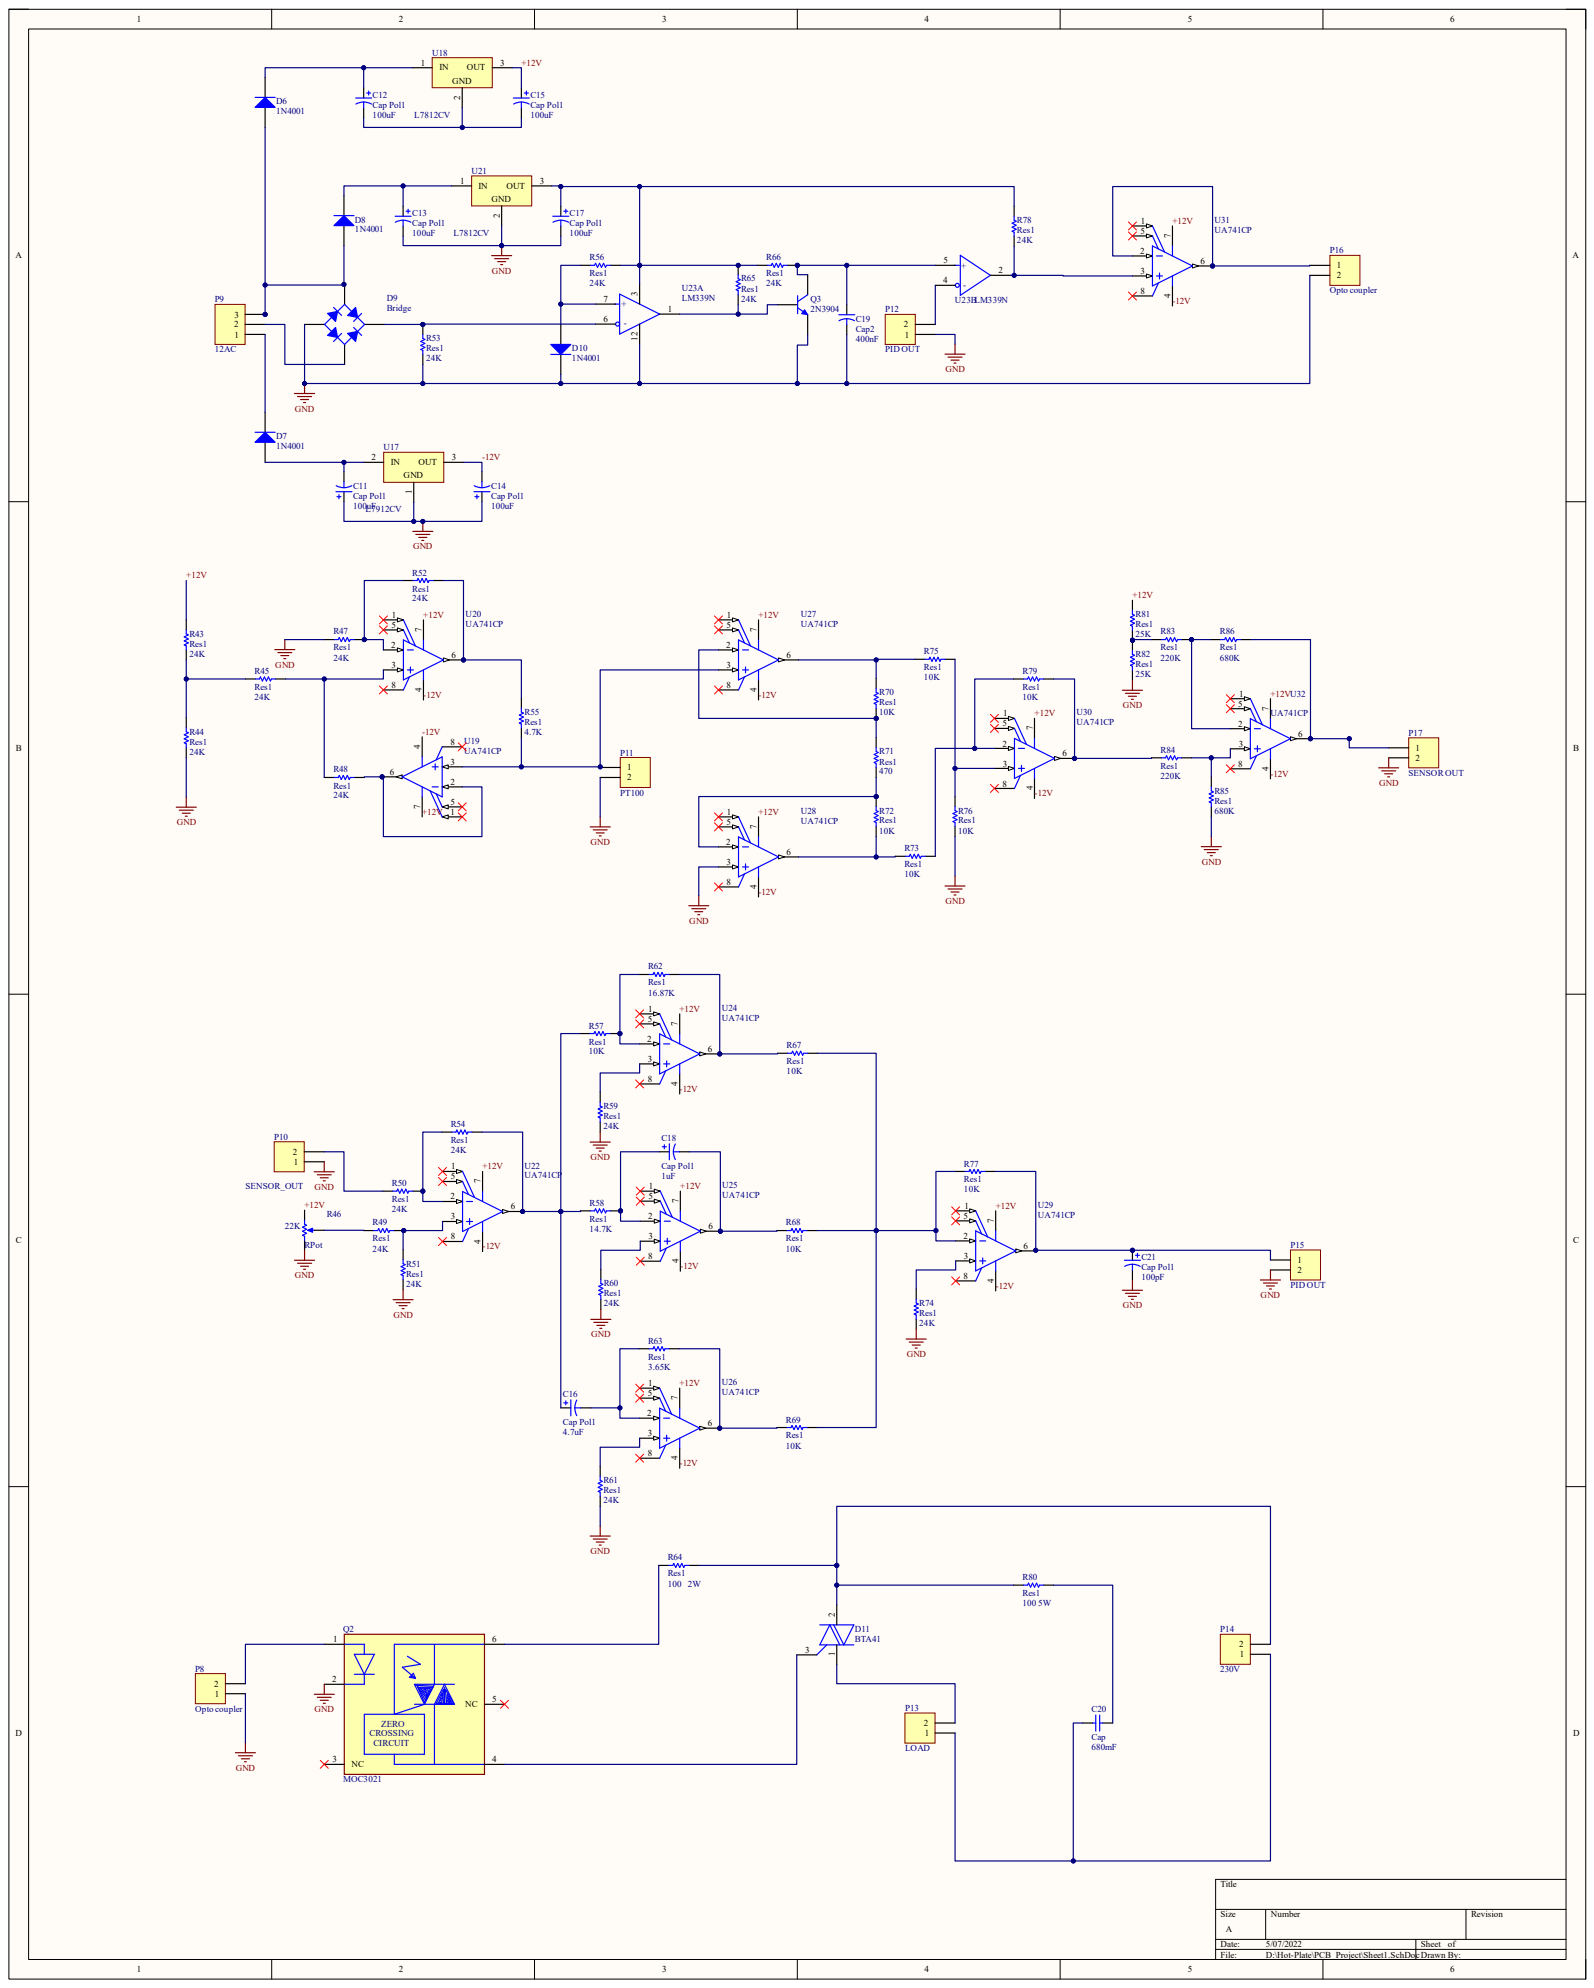
[picture p130: page 1]
