dakshinatharindu/Hot-Plate/(list of files, drawings)

Other design files:
Enclosure/Hot-Plate-using-PID-main/Hot Plate/Multisim test/firing angle controlling system-without the transistor.ms14
Enclosure/Hot-Plate-using-PID-main/Hot Plate/Multisim test/PID-CCT.ms14
Enclosure/Hot-Plate-using-PID-main/Hot Plate/Multisim test/power suply circuit.ms14
Enclosure/Hot-Plate-using-PID-main/Hot Plate/Multisim test/sensor.ms14
PCB/Copy of PCB1.PcbDoc
PCB/PCB1.PcbDoc
PCB/PCB.PrjPcb
PCB/pid.SchDoc
PCB/schematic.SchDoc
PCB/sensor.SchDoc
PCB/Sheet1.SchDoc
PCB/Triac.SchDoc
PCB_design/Firing_Angle_Controlling.PcbDoc
PCB_design/Firing_Angle_Controlling.SchDoc
PCB_Project/PCB1.PcbDoc
PCB_Project/PCB_Project.PrjPcb
PCB_Project/Sheet1.SchDoc
PID Controller/PID controller fnl.pdsprj
Sensor Interface/Sensor Inpit.pdsprj
Triac Circuit/Triac Circuit with the snubber circuit.pdsprj
Triac Controller/Hot Plate.pdsprj
