dakshinatharindu/Hot-Plate/(commit log)

2022-03-11 simulation is fine.
    [Hot Plate.pdsprj]
2022-03-12 sensor input interface.
    [Sensor Inpit.pdsprj]
2022-03-12 sensor input interface
    [Sensor Inpit.pdsprj]
2022-03-13 PID controller for 10V
    [PID controller fnl.pdsprj]
2022-03-13 list of Enclosure enclosure
2022-03-13 List of enclosure parts
2022-03-16 pid res values
    [Hot Plate.pdsprj, PID controller fnl.pdsprj, Sensor Inpit.pdsprj]
2022-03-17 Enclosure box updated
    [Hot plate box.SLDPRT]
2022-03-17 pcb schematic of triac control circuit
    [Firing_Angle_Controlling.PcbDoc, Firing_Angle_Controlling.SchDoc]
2022-03-24 final enclosure and other parts
    [AC_Power_Socket-3_pin_250V_10A_AC-17.IGS, AC_Power_Socket-3_pin_250V_10A_AC-17.SLDPRT, AC_Power_Socket-3_pin_250V_10A_AC-17.STEP, Assem1.SLDASM, Case_PC.SLDPRT, FINAL PART.SLDASM, Fuse Small 1A.SLDPRT, Fuse_contact.SLDASM]
2022-04-28 Firing angle controller circuit
    [Triac Circuit with the snubber circuit.pdsprj]
